Tiberion/important-documents/Bracket, sensor actuator- Addons/Circuit/Motorboard-Layout-1.tiff

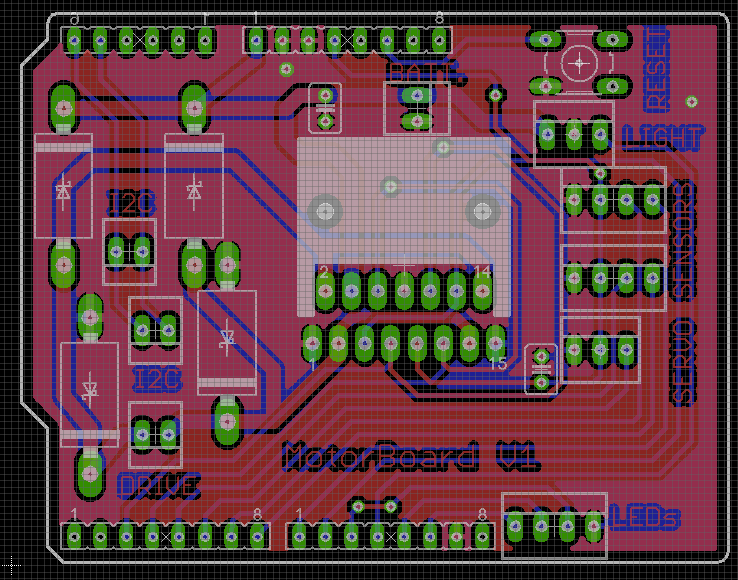
Bracket, sensor actuator- Addons/Circuit/Motorboard-Layout-1.tiff
