Tiberion/important-documents/README.md

important-documents
===================

This is a filesystem where you can find all finished documents.

[Here is the link to the mainpage of the wiki.](https://github.com/Carduinodroid/carduinodroid/wiki)
