Tiberion/important-documents/Start of the project/1 - Functional specification document/Presentation.pptx

Auto, Arduino, Android
- CarDuinoDroid

Lewandowski, Benjamin
Lewandowski, Felix
Behlau, Benjamin
Schulze, Christian
Strenger, Robin
Haueisen, Sven
Thorwirth, Paul
Vogel, Lars

CarDuinoDroid

## Slide 2

Gliederung

1. Einleitung
2. Anwendung
3. Zielkriterien
4. Umsetzung
5. Benutzeroberfläche
6. Unsere Zielbestimmungen

CarDuinoDroid

## Slide 3

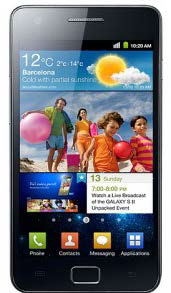
[picture p2: figure]

1. Einleitung

Teil 1: Arduino-Zugriff durch das AOADK

(Teil 2: Anbindung des Arduino-Boards an
die Modellfahrzeug-Bordelektronik)

Teil 3: Entwicklung einer Android-Applikation
als Drohnen-Steuer-Server

Teil 4: Entwicklung einer PC-Software
zur Drohnen-Steuerung

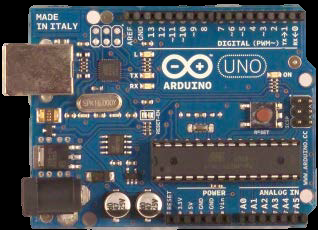
[picture p3: figure]
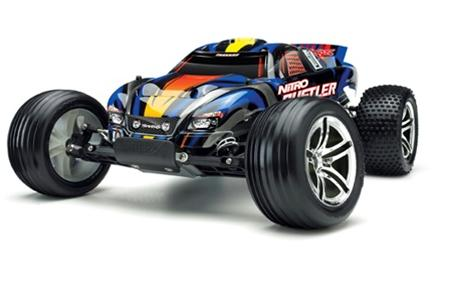
[picture p4: figure]

CarDuinoDroid

## Slide 4

2. Anwendung

Für wen?

Wo?

Wie?

Wie effizient ?

Anpassungsfähig?

CarDuinoDroid

## Slide 5

3. Zielkriterien

Muss
Wunsch
Abgrenzung

CarDuinoDroid

## Slide 6

4. Umsetzung

Android-Funktionen
Java-Funktionen
Oberfläche

CarDuinoDroid

## Slide 7

5. Benutzeroberfläche

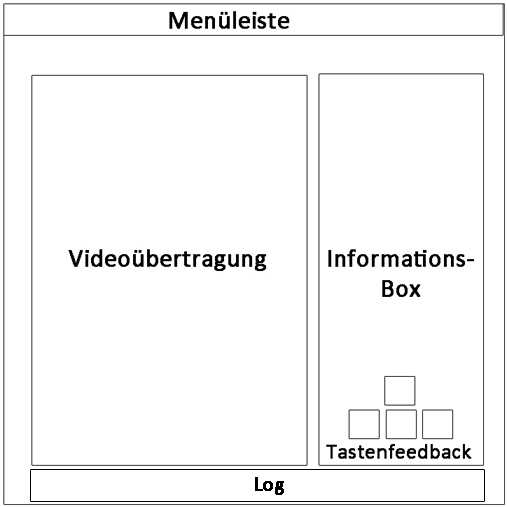
[picture p5: figure]

Möglicher
Oberflächenaufbau

CarDuinoDroid

## Slide 8

6. Unsere Zielbestimmungen

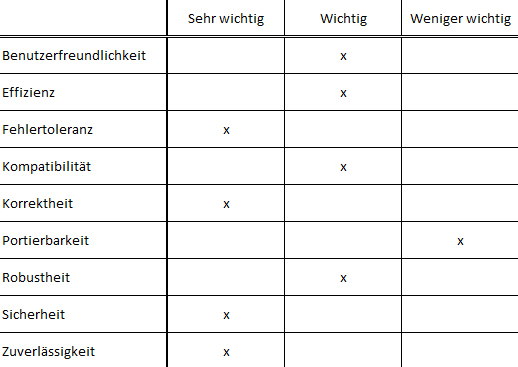
[picture p6: figure]

CarDuinoDroid

## Slide 9

Vielen Dank für Ihre Aufmerksamkeit!

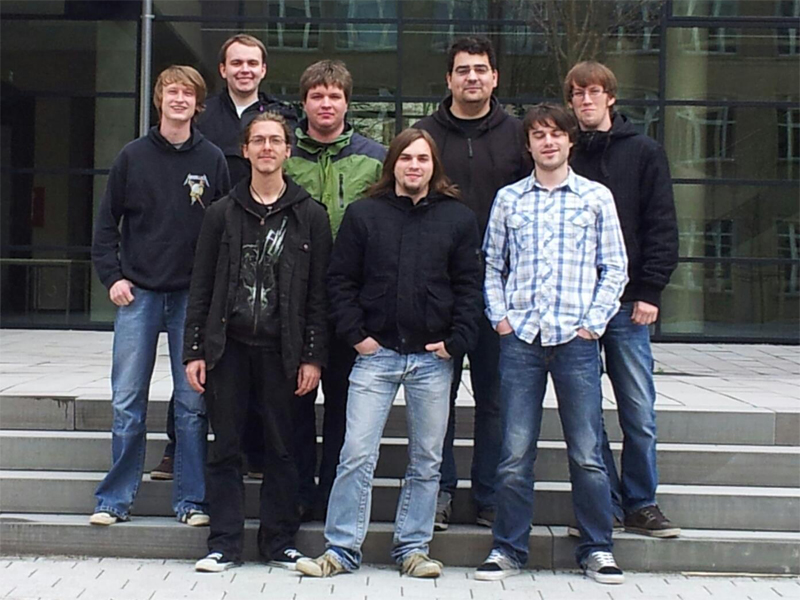
[picture p7: figure]

CarDuinoDroid
