Tiberion/important-documents/Bracket, sensor actuator- Addons/Presentation.pptx

## Sensor-Aktor-Integration auf einer mobilen Arduino-Plattform

Hauptseminar
Harald Funk

www.tu-ilmenau.de

## Gliederung

- Vorhandener Aufbau und Aufgabenstellung
- Erweiterung der Hard- und Software des Modellfahrzeuges
- Ansteuerung des entstandenen Gesamtsystems
- Zukünftige Erweiterungsmöglichkeiten
- Demonstration
- Quellen

## Vorhandener Aufbau

- Modellfahrzeug Street-Breaker der Firma Carson
- Umgebaut auf Ansteuerung durch einen Arduino
- Selbstgelötete Motortreiberplatine mit undokumentierter Schaltung
- Auf Arduino-Board gesteckt und mit Klebeband fixiert
- Smartphone als Bridge zwischen Steuerrechner und Arduino mit Klettband befestigt

Notes: Arduino nur mit 1 Schraube fixiert => Halterung gebaut

## Vorhandener Aufbau

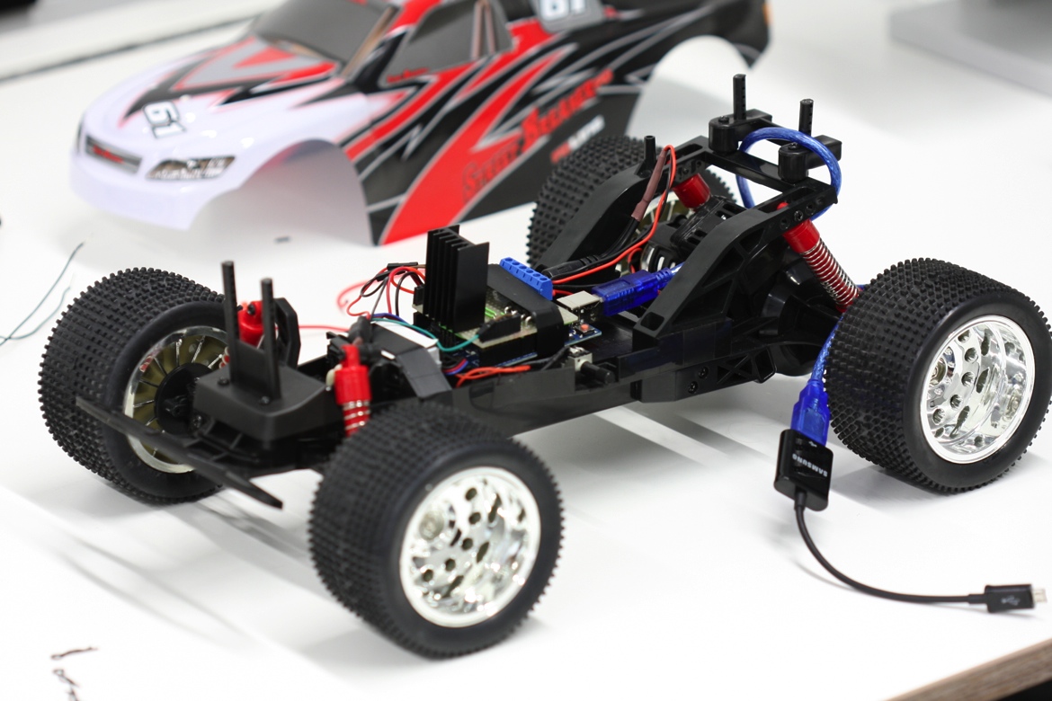
[picture p8: figure]
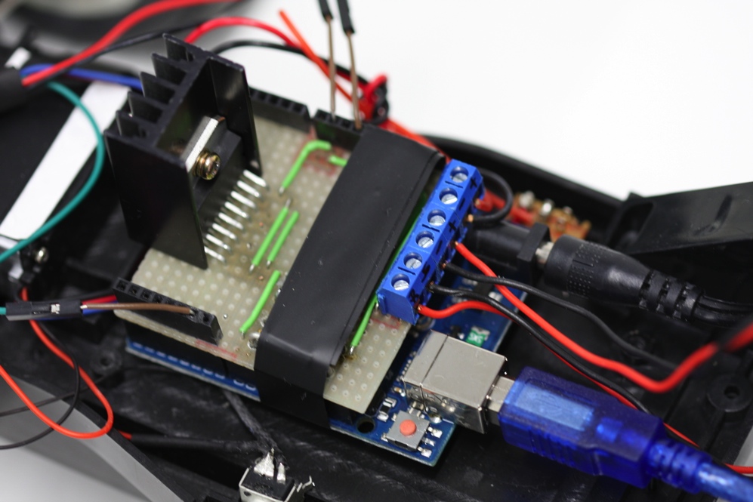
[picture p9: figure]

Notes: oben: Fahrzeug im Ganzen
langes USB-Kabel
unten: Treiberplatine
Schwerpunkt am vorderen Ende
Klebeband
Lochrasterplatine
Kabel ohne Befestigung gesteckt

## Aufgabenstellung

- Arduino- und Motorsteuerungsplatine sicher auf Fahrgestell befestigen
- 3 LEDs zur Anzeige von Power on/off, Connection on/off und frei programmierbar am Gehäuse anbringen und ansteuern
- 2 High-Power LEDs für Licht am Gehäuse anbringen und ansteuern
- Kapazitätsmessung der Batterie ermöglichen
- Handyhalterung entwickeln und einbauen
- Ultraschall-Sensor aussuchen, anbauen und implementieren
- Leitungen zwischen Platinen und Motoren neu und sauber verlegen
- USB-Kabel und Adapter kürzen

## Erweiterung der Hard- und Software

- Aufbau und Schaltung der Motorsteuerungsplatine
- Messung der Akkukapazität
- Verwendung und Auswertung des Ultraschallsensors HC-SR04
- Schaltung und Steuerung der High-Power LEDs und der Status-LEDs
- Konstruktion und Einbau der Handyhalterung

## Aufbau und Schaltung der Motorsteuerungsplatine

- Vorhandene Platine nicht erweiterbar
- Beibehaltung des grundlegenden Aufbaus
  - Entwicklung einer neuen Platine mit passenden Steckverbindern für Peripherie
- Beachtung des Schwerpunktes der Platine
- Schaltung und Layout mit Freeware Eagle

Notes: sehr eng und unsauber gelötet
Aufwand zum Ändern höher als Neuaufbau
Kondensatoren gemäß Datenblatt

## Aufbau und Schaltung der Motorsteuerungsplatine

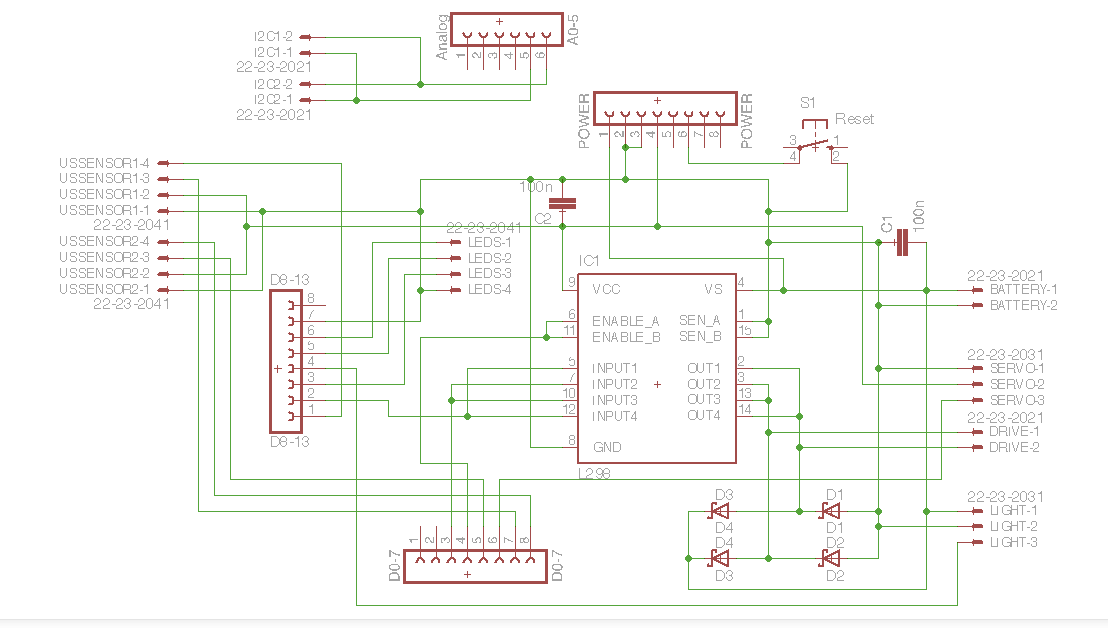
[picture p10: figure]

Notes: Mitte:L298N Motortreiber 2 Vollbrücken, antiparallel
Unten Rechts: Freilaufdioden für Überspannungsschutz
Oben Rechts: Reset-Knopf für Arduino
Ansonsten: Steckverbinder für Peripherie

## Aufbau und Schaltung der Motorsteuerungsplatine

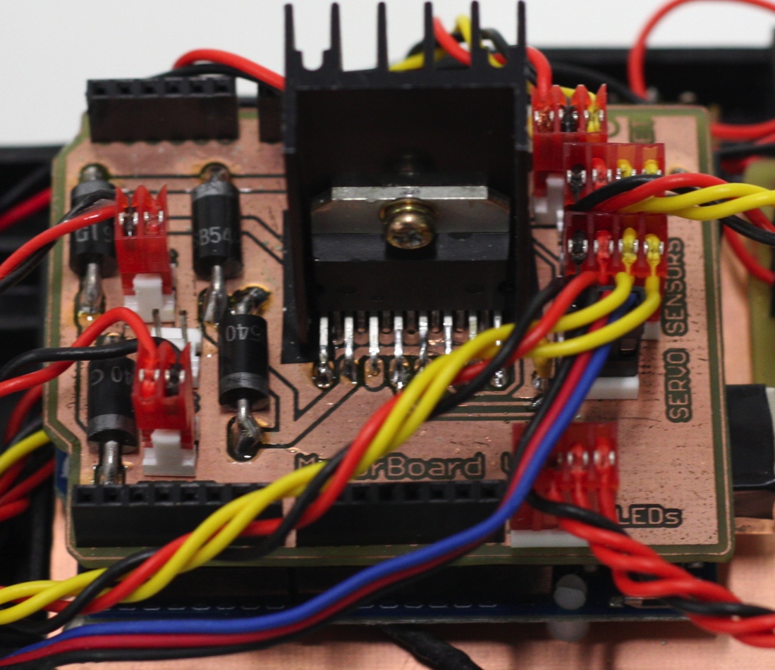
[picture p11: figure]
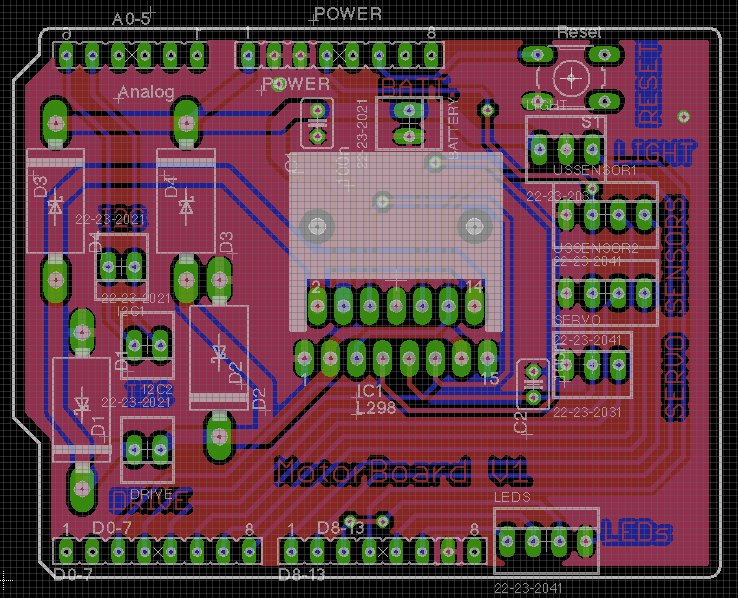
[picture p12: figure]

Notes: Platine wurde selbst entwickelt und geätzt

## Messung der Akkukapazität

- Auswahl einer geeigneten Methode Spannungsmessung Strommessung
- Spannungsmessung: Starke Nichtlinearität im Verhältnis Spannung/Kapazität → über weite Bereiche kaum messbar
- Strommessung: Integration des Stroms über die Zeit ≙ Kapazität
  - über spezialisierte ICs messbar

Notes: Nicht so einfach:
1,4V = voll
0.8V = leer
=> 1.1 V = halbvoll

## Messung der Akkukapazität

- Auswahl des DS2745 „Low-Cost Battery Management“ Chips
  - Messung des Spannungsabfalls (≙ Strom) über einen Präzisionswiderstand
  - Integration des gemessenen Spannungswertes
  - Ansprechbar mittels I²C-Bus über den Arduino
  - Erfasst ebenfalls Versorgungsspannung und Temperatur

Notes: +-51,2mV Spannungsmessbereich Auflösung 16Bit
Zweidrahtleitung
Speicherung in Registern, welche Ausgelesen und Beschrieben werden können

## Messung der Akkukapazität

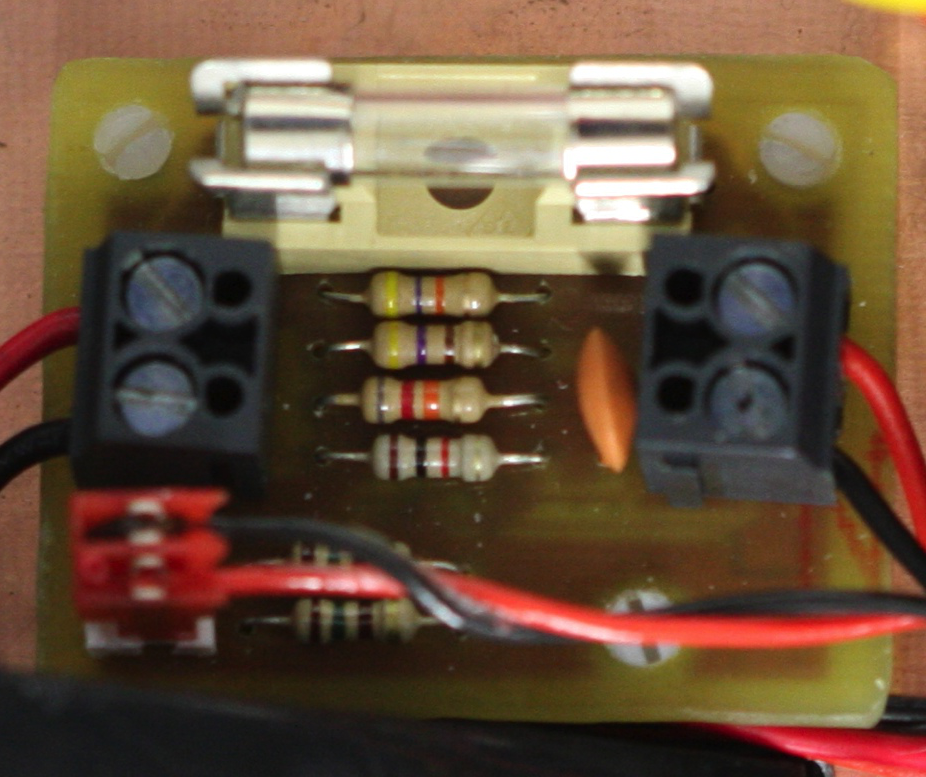
[picture p13: figure]
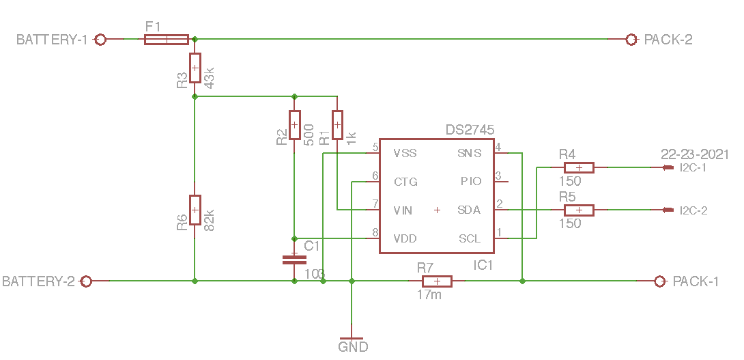
[picture p14: figure]
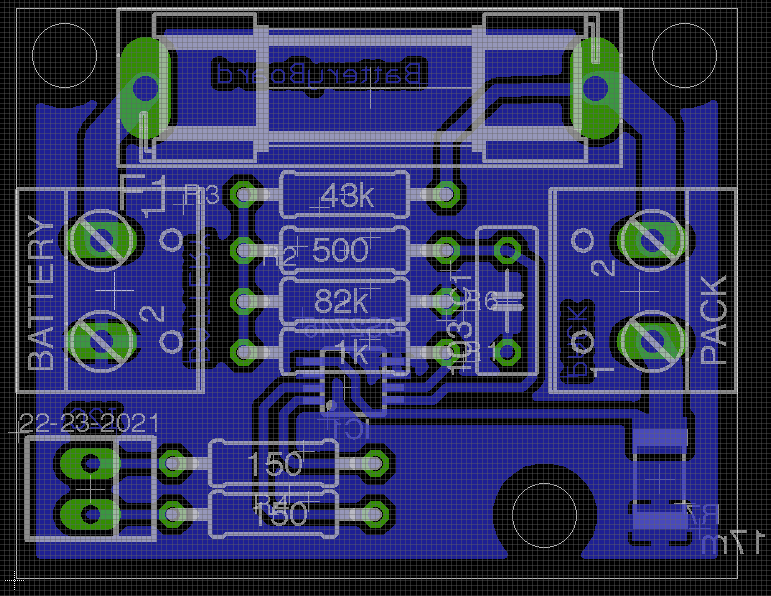
[picture p15: figure]

Notes: Mitte: DS2745 Battery Management
Links: Versorgungsspannung Batterie
Rechts: Spannungsausgang für Mikrokontroller
Unten: RSNS : ShuntWiderstand zur Messung des Stroms

## Verwendung und Auswertung des Ultraschallsensors HC-SR04

- Messung des Abstandes zu Hindernis in Fahrtrichtung (< 3m)
- Restriktiver Eingriff in Steuerbefehle abhängig vom Abstand
- Ansteuerung mittels Trigger- und Echo-Pins
- Messung der Zeit → Abstand zum Hindernis

Notes: 2 Sensoren montiert
Kein I2C oder UART, dafür billig

## Verwendung und Auswertung des Ultraschallsensors HC-SR04

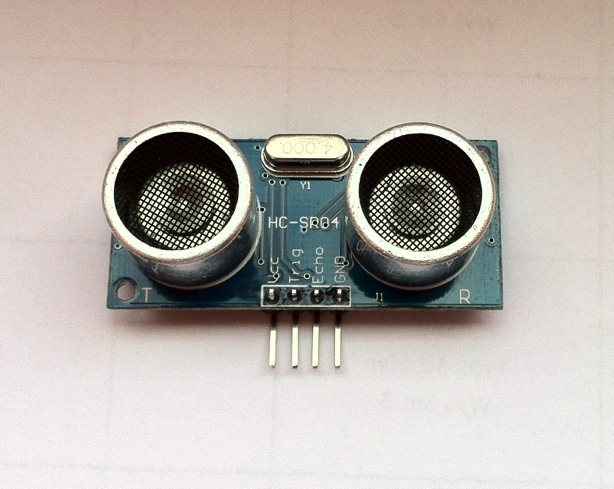
[picture p16: figure]
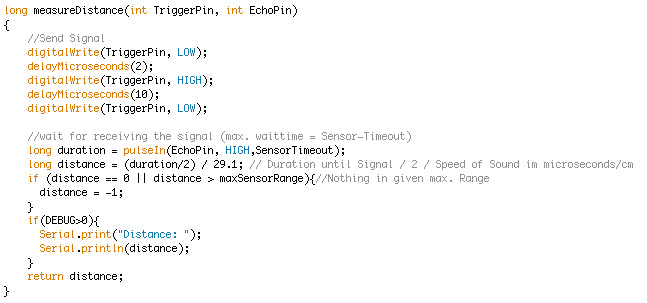
[picture p17: figure]

Notes: 2µs zur Stabilisierung des Pegels
Formel: Abstand = Zeitdauer/2/29.1cm/µs

## High-Power LEDs und Status-LEDs

- Einsatz von 2 x 1W-High-Power LEDs
- Ansteuerung mittels ILD4035 LED-Treiber (350mA)

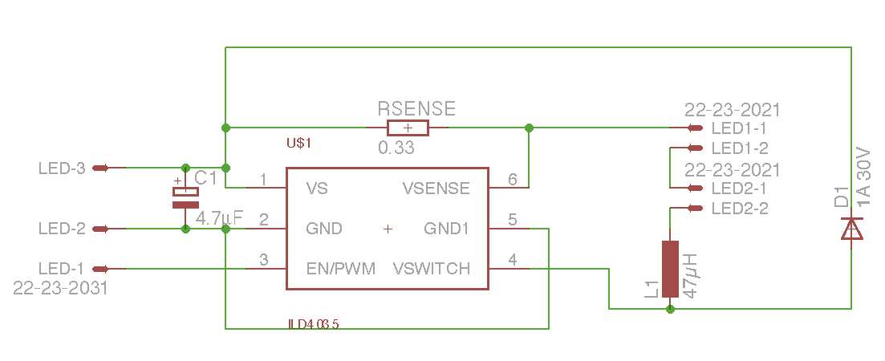
[picture p18: figure]

Notes: Mitte: ILD4035 Treiber
Kondensator: Abblocken hochfrequenter Störungen
Spule: Verringern des Ein-Ausschaltstroms
Diode: Schottky Ausführung => bricht schneller durch

## Konstruktion und Einbau der Handyhalterung

- Konstruktion mittels Autocad Inventor
- Druck auf 3D-Drucker des Fachgebiets IHS
- Anbau an Fahrgestell des Modellfahrzeuges
- Halterung für Micro-USB Kabel des Smartphones zum einfachem Verbinden durch Einstecken

## Konstruktion und Einbau der Handyhalterung

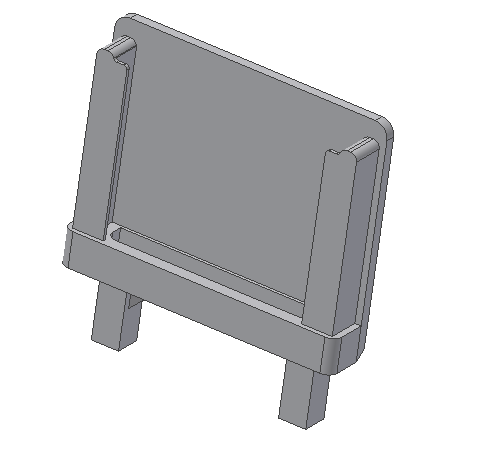
[picture p19: figure]
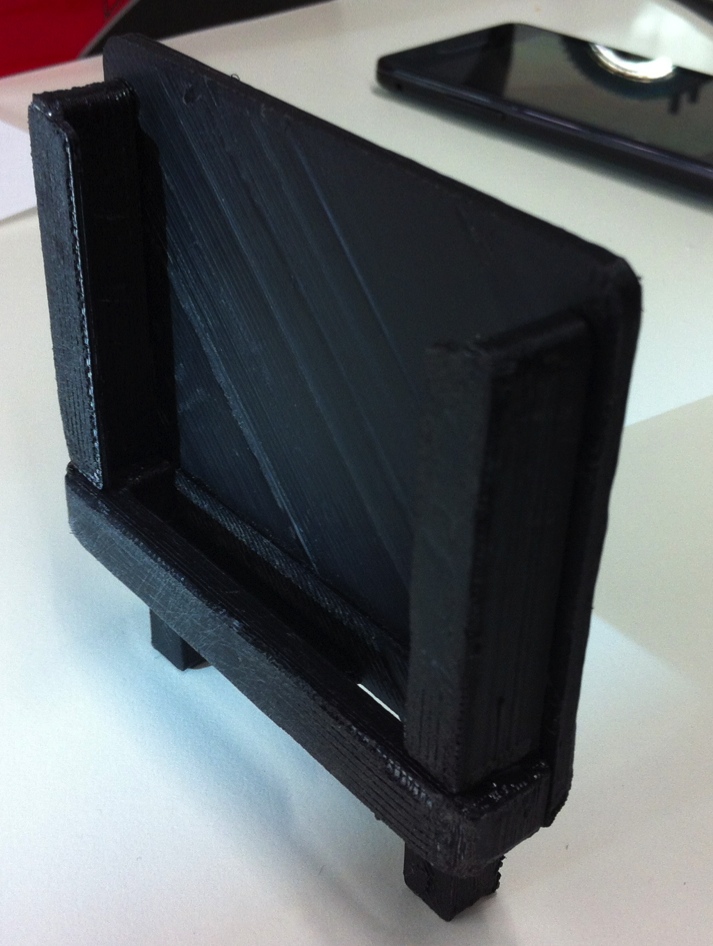
[picture p20: figure]

## Ansteuerung des entstandenen Gesamtsystems

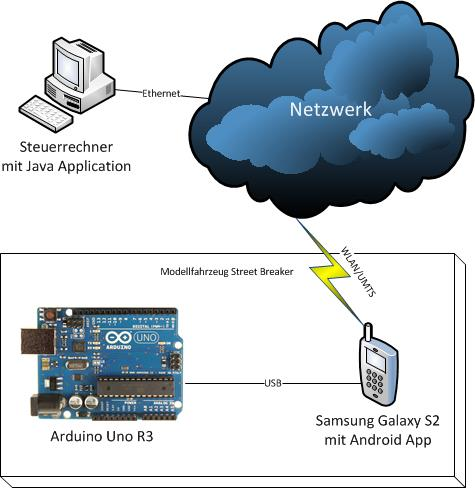
[picture p21: figure]

## Ansteuerung des entstandenen Gesamtsystems

- Java-Applikation und Android-App nicht Teil des Hauptseminars
- Durch Anbauten neues Protokoll zwischen Arduino und Smartphone notwendig
- Zusammenfassung mehrerer alter Steuerbytes
- Hinzufügen eines Protokoll-Headers, neues Byte für Anbauten
- Hinzufügen einer Status-Antwort auf Steuerbefehle

## Zukünftige Erweiterungsmöglichkeiten

- Erweiterung der vorhandenen Software auf neue Sensorik und Aktuatorik
- Anschluss weiterer I²C-kompatiblen Sensoren und Aktoren möglich
- Erweiterung des Protokolls über die Nutzung reservierter Bits oder einer neuen Protokollversion möglich

## Vielen Dank für Ihre Aufmerksamkeit

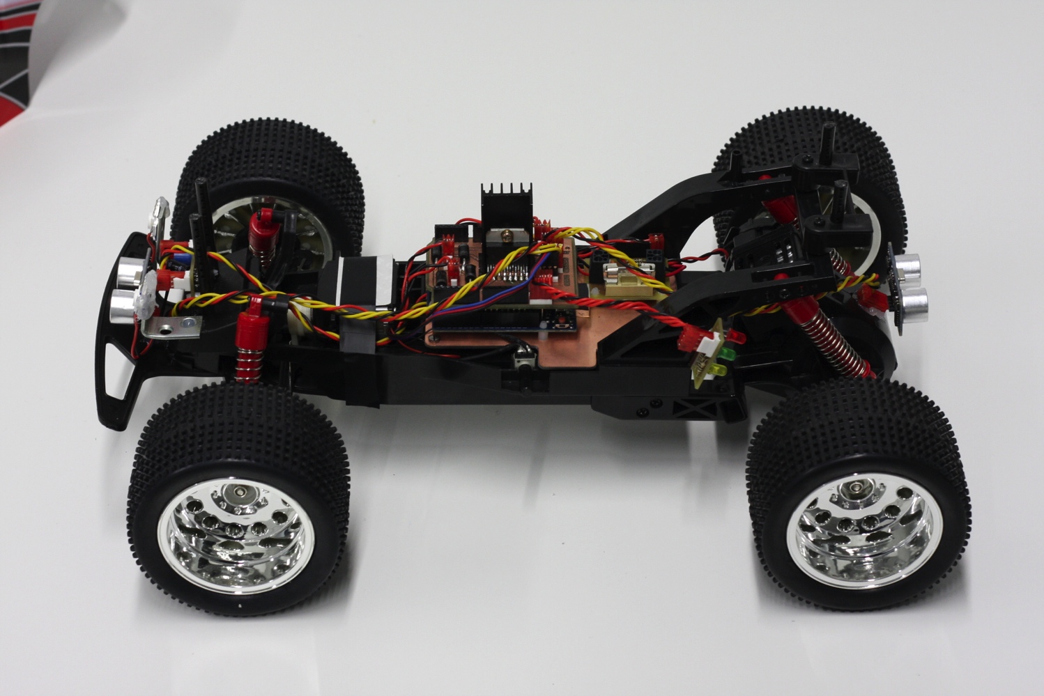
[picture p22: figure]

DEMO

## Quellen

- Schaltungstechnik; Johann Siegl; Springer Verlag; 3. Auflage
- Eagle Handbuch; Cadsoft Computer GmbH; Version 6 http://www.cadsoft.de/wp-content/uploads/2011/05/V6_manual_de.pdf
- Mikrocontroller.net; Leiterbahnbreite; Aufgerufen am 17.10.2013 http://www.mikrocontroller.net/articles/Leiterbahnbreite
- Akkukonfigurator.de; Firma Akkuline OHG; Aufgerufen am 30.09.2013; http://www.akkukonfigurator.de/NiCD-NiMH_Akku-Spannung.aspx
- Nickel-Metallhydrid-Akku; Elektronik-Kompendium; Aufgerufen am 30.09.2013; http://www.elektronik-kompendium.de/sites/bau/1101251.htm
- Datenblatt DS2745; Maxim Integrated; Version 2; Aufgerufen am 26.05.2013; http://datasheets.maximintegrated.com/en/ds/DS2745.pdf
- Arduino Homepage; arduino.cc; Aufgerufen am 19.07.2013;
- Arduino Playground; playground.arduino.cc; Aufgerufen am 19.07.2013
- Datenblattt HC - SR04; ElecFreaks.com; Aufgerufen am 04.10.2013; http://elecfreaks.com/store/download/HC-SR04.pdf
- Datenblatt ILD4035; Avago Technologies; Aufgerufen am 04.10.2013; http://www.avagotech.com/docs/AV02-1673EN
- Datenblatt L298N; STMicroelectronics ; Aufgerufen am 10.06.2013; http://www.st.com/st-web-ui/static/active/en/resource/technical/document/datasheet/CD00000240.pdf
