Tiberion/important-documents/Start of the project/3 - Implementation/Implementation process.pdf

1. | Teambesprechung 1. | Teambesprechung

## Zeitplanung Zeitplanung

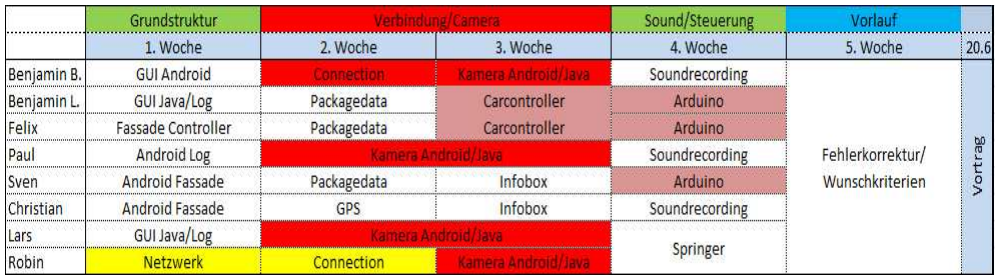
[picture p52: figure]

## Aufbau Grundstruktur Aufbau Grundstruktur

Aufbau der Fassaden Aufbau der Fassaden

GUI Java GUI Java

Grundversion der grafischen Oberfläche steht mit den grundlegenden Einstellmöglichkeiten.

Zudem wird an dieser weiterhin gearbeitet und alle neuen Funktionen implementiert.

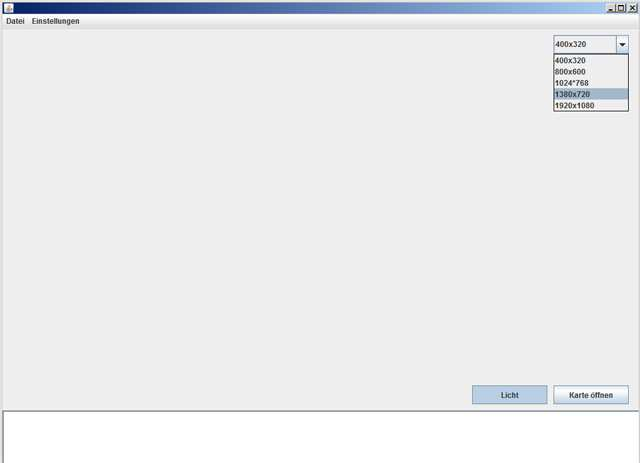
[picture p53: figure]

# GUI Android GUI Android

Anbei die fertiggestellte Oberfläche im Android.

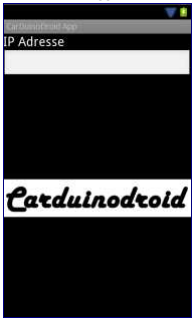
[picture p54: figure]

Log Java / Android Log Java / Android

Log Funktion vom Android komplett funktionsfähig. Währenddessen bei dem Java-Programm

noch Anpassungen erfolgen bezüglich kleiner Denkfehler im Entwurf.

## Aufgabenverteilung Aufgabenverteilung

Paul: GPS_Daten und Connection/Verbindung auslesen+ Zusammenführen Klassen

Robin: Verbindungsaufbau(Netzwerk) und Kameradaten(Aufnehmen und Senden)

Benjamin L: GUI_Java + Informationsbox mit Werten aktualisieren

Sven: Zusammenführen Klassen + JavaDoc/Doxygen belesen und Tutorial einbinden ins Trac

Benjamin B: Icon/IP-Auslesen, Eingliedern bei Problemen in Gruppen

Christian: Soundrecording

Felix: Soundpool, Controller_Java, Eingliedern bei Problemen in Gruppen

Lars: Package (Java auseinandernehmen)-Informationen + Android-Arduino

(Übertragung/Befehle)

Für alle Threads auslesen für Oberfläche Java und JavaDoc

# 2.Teambesprechung 2.Teambesprechung .Teambesprechung

# GUI Java GUI Java

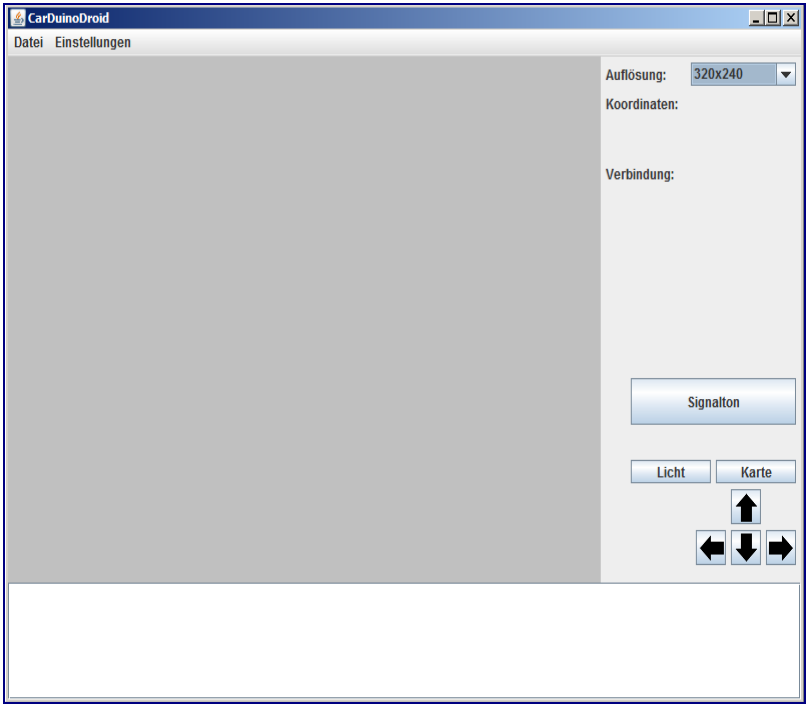
[picture p55: figure]

## GPS-/Verbindungsdaten auslesen /Verbindungsdaten auslesen /Verbindungsdaten auslesen

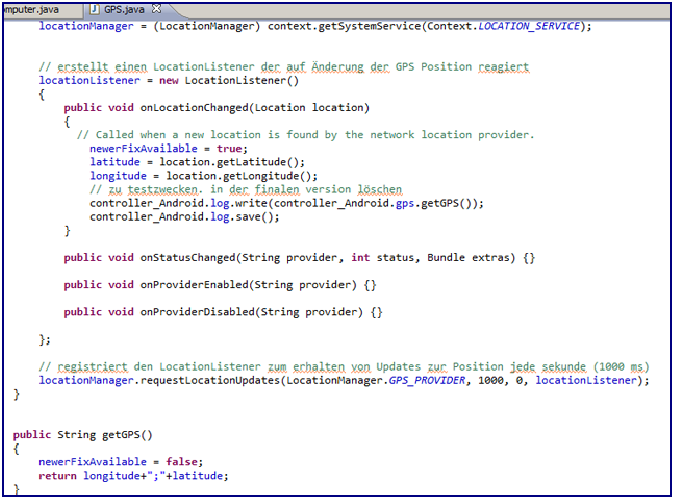
[picture p56: figure]

## Verbindungsaufbau Verbindungsaufbau

Das Senden von Informationen und Daten ist fertiggestellt. Die ersten Testwerte werden im

Zusammenspiel zwischen Lars und Robin erstellt und auseinandergenommen.

## Bildübertragung Bildübertragung

Das große Problem des Projektes, da die Übertragung bisher immer mit stärker Verzögerung

behaftet ist. Testprogramme klappen nur in geringen Prozentzahlen, wobei auch hier ein Delay

bis teilweise 10s vorhanden sind (je nach Umsetzungsart).

## IP-Adresse auslesen Adresse auslesen Adresse auslesen

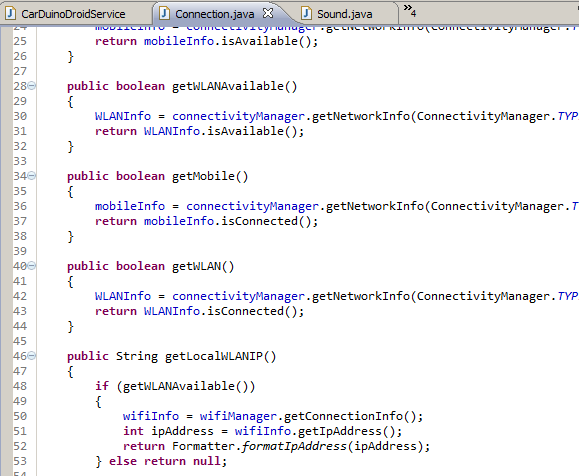
[picture p57: figure]

## Soundpool Soundpool

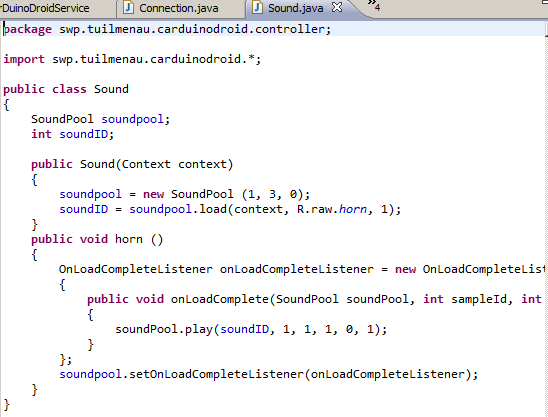
[picture p58: figure]

## Arduino- Arduino-Befehle senden Befehle senden Befehle senden

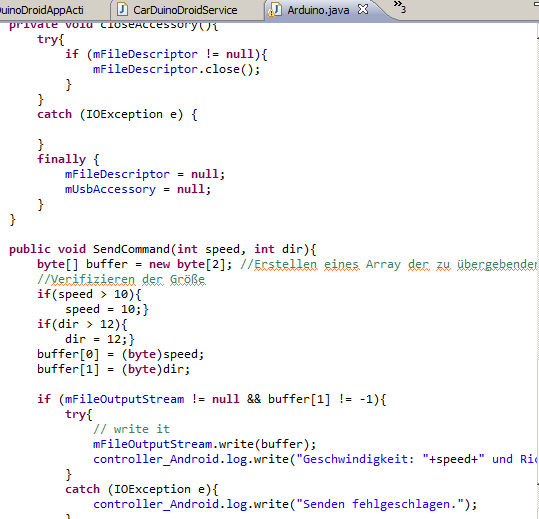
[picture p59: figure]

## Festlegung auf JavaDoc Festlegung auf JavaDoc

## Aufgabenverteilung Aufgabenverteilung

Benjamin L: GUI_Java mit Implementierung Methoden

Robin: Verbindungsaufbau(Netzwerk) und Kameradaten(Aufnehmen und Senden) sowie Android

App Rest

Lars: Sound Output + Camera Settings + Car Controller Java

Christian: Soundrecording + Paketdata Java

Sven: Entwurfsphase Trac fertigstellen + GPS Map plus Model GPS (gpx-Format)

Paul: Anpassen Arduino Service + Arduino Rest

Benjamin B: Springer

Felix: Springer

# 3. Teambesprechung

## Sound Output Sound Output

Klasse mit Methoden wurde mit dem ActionListener verknüpft und kann vollständig benutzt

werden. Log Funktion ist zudem implementiert, die sich in die Aktion "Sendeanforderung" und

die Prüfung einer erfolgreichen Aktion gliedert.

## Camera Setting Camera Setting

Alle notwendigen Methoden (Licht, Kameraauflösung und Kameratyp) wurden implementiert und

von der Oberfläche wird der Status ausgelesen. Die Log Funktion ist zudem implementiert, die

sich in die Aktion "Sendeanforderung" und die Prüfung einer erfolgreichen Aktion gliedert.

## Soundrecording Soundrecording

Das Starten und Stoppen wird als Signal aufbereitet sowie als Methoden zur Verfügung gestellt.

Die Log Funktion ist zudem implementiert, welche sich in die Aktion "Sendeanforderung" und

die Prüfung einer erfolgreichen Aktion gliedert.

## Packagedata Packagedata

Das Gliedern der empfangenen Message über das Netzwerk wird anhand der ";"-Trennung

gewährleistet und in einem Array gespeichert.

## Car Controller Car Controller

Der Konstruktor mit grundlegenden Methoden wurde bereitgestellt. Umrechnung für Lenkwinkel

und Geschwindigkeitsparameter wurde bisher noch nicht eingebunden. Zudem fehlt das

Auslesen/Übergeben der Werte von dem GUI.

## GPS Map/ Track GPS Map/ Track ap/ Track

Nicht Fertiggestellt

# Android Applikation Android Applikation

Große Schritte im Zusammenspiel der einzelnen Klassen sichergestellt. Umänderung von Service

auf Activity bedingt durch die Kamera. Hier muss eine Activity gewährleistet sein, um Bilddaten

auslesen sowie übertragen zu können. Arduino Klasse wurde dementsprechend verändert, dass

die Methodik auf Activity wieder umgestellt wurde und benötigt nun einen Echtzeittest, ob

übertragene Signale auf Seiten des Arduino verarbeitet werden können.

## Aufgabenverteilung : Aufgabenverteilung :

Java

Benjamin L.: GUI (Car_Controller Elemente auf GUI, Bildverarbeiten/-anzeigen,

Feinheiten)

Lars: ActionListener (restliche Verknüpfung mit GUI)

Springer: Camera Pic weiterleiten

Christian: Package Data

Sven, Felix, Benjamin B.: GPS: Button zum Anzeigen Google Maps und *.gpx speichern

Robin: Kamerabilder übertragen

## Android

Robin, Paul:

Kamera

Controller

Arduino anpassen (Rest)

# 4.Teambesprechung 4.Teambesprechung

## Car_Controller mit KeyListener Car_Controller mit KeyListener

Funktionierende Abfrage der Tasten über Variablen setzen/löschen gelöst, um den

Mehrfachdruck zu lösen. Dabei kann einerseits das Auto per Pfeiltasten gelenkt und zu gleicher

Zeit die beigefügten Gänge zur Regulierung der Geschwindigkeit genutzt werden. Auch besteht

die Möglichkeit den Lenkwinkel zu steuern, um zu starke kurven bei hoher Geschwindigkeit zu

vermeiden. Dieser Funktionsumfang kommt vollkommen ohne Logeinträge aus, um unnötigen

Datentraffic zu vermeiden.

## *.gpx-File (Wunschkriterium) File (Wunschkriterium) File (Wunschkriterium)

Das Speichern des Routenverlaufes einer Strecke wird dahingehend gewährleistet, dass eine

demnentsprechende Datei beim Start des Java-Programms angelegt wird, die bei neuen GPS-

Informationen die wichtigen Daten in den Log schreibt. Mit dem normalen Beenden des

Programms wird die Datei mit den restlichen Informationen gefüllt, um auf diversen

Routenprogrammen sowie Internetseiten die Strecke anzeigen zu können.

## Verbinden ActionListener mit GUI Verbinden ActionListener mit GUI

Restliche ActionListener wurden mit den Aufrufen auf der GUI verbunden. Mit dem Log konnte

die Funktionalität sicher gestellt werden.

# Live-Log

Die detaillierte und zeitnahe Anzeige des Live-Logs auf dem GUI versorgt den Nutzer mit

ausreichend Informationen über den genutzten Funktionsumfanges des Programms. Fehler in

Verbindung sowie Sendeprobleme werden darin auch ausgewiesen.

## JavaDoc Beispiel JavaDoc Beispiel

Ein erstes JavaDoc Beispiel wurde in eine der zahlreichen Klassen eingebunden, um für alle

anderen die nötigen Grundlagen zu schaffen, die eigenen Programmteile zu dokumentieren.

Besonders die Beschreibung von Methoden und der Klasse stellen den Hauptbestandteil dar.

## Sprachdateien einbindbar Sprachdateien einbindbar

Man kann per Sprachdateien die komplette Oberfläche einfach und unkompliziert ändern. Dabei

müssen die Einträge nur zeilenweise übersetzt und angepasst werden. Dies gewährleistet eine

internationale Nutzung des Programms

## unvollständige Teile unvollständige Teile

Arduino-USB-Steuerung: durch fehlene Testmöglichkeit kann die Klasse mit den

jeweiligen Methoden nicht in einer Live-Umgebung getestet werden

Bildübertragung: Probleme bezüglich der Verzögerung in vielen getesteten

Programmiervarianten haben bisher die Anzeige erschwert. Weitere Methoden werden

ausprobiert um das "Delay" auf ein Minimum zu reduzieren. Weiterhin noch Hardware

technische Probleme bezüglich der Bilderverarbeitung (teilweise Handys zu langsam)

Aufgabenverteilung letzte Implementierungswoche Aufgabenverteilung letzte Implementierungswoche

JavaDoc auskommentieren für alle. Robin/Paul:

Rest von Android Felix/Sven/Paul: Darstellung der Bilddaten auf GUI Java

Benjamin/Lars: Anpassungssachen Java

Christian: Vortrag Teile entwerfen, PDF
