Tiberion/important-documents/Bracket, sensor actuator- Addons/Circuit/attachment-schematics.tiff

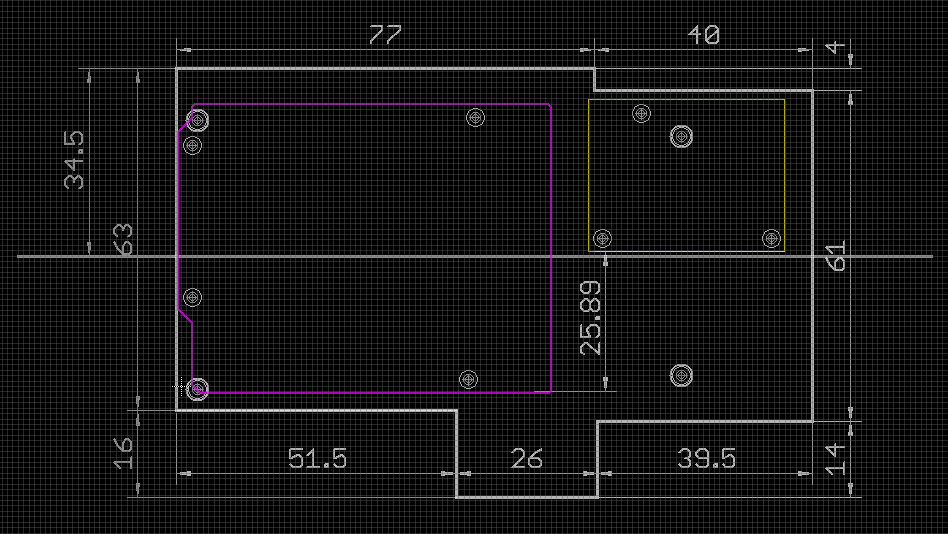
Bracket, sensor actuator- Addons/Circuit/attachment-schematics.tiff
