Tiberion/important-documents/Bracket, sensor actuator- Addons/Circuit/Battery-Layout-1.tiff

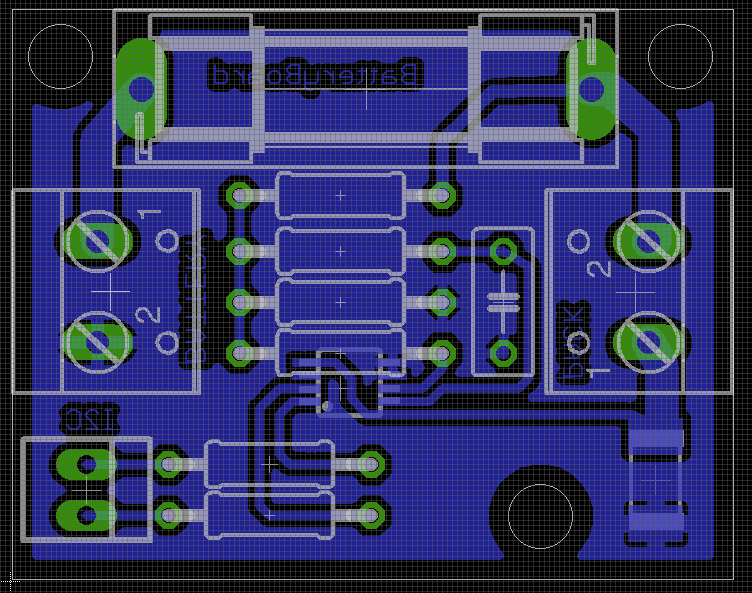
Bracket, sensor actuator- Addons/Circuit/Battery-Layout-1.tiff
