Tiberion/important-documents/Bracket, sensor actuator- Addons/Circuit/LED-Schematics.tiff

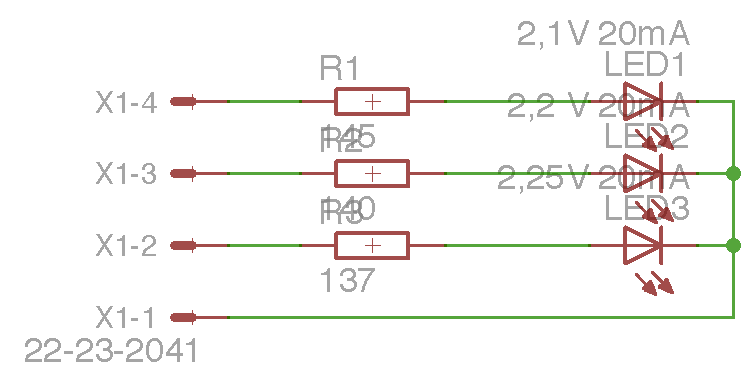
Bracket, sensor actuator- Addons/Circuit/LED-Schematics.tiff
