Tiberion/important-documents/Bracket, sensor actuator- Addons/Circuit/LEDs-Layout-1.tiff

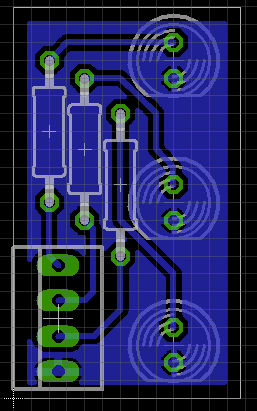
Bracket, sensor actuator- Addons/Circuit/LEDs-Layout-1.tiff
