Tiberion/important-documents/Bracket, sensor actuator- Addons/Circuit/LEDs-Layout.tiff

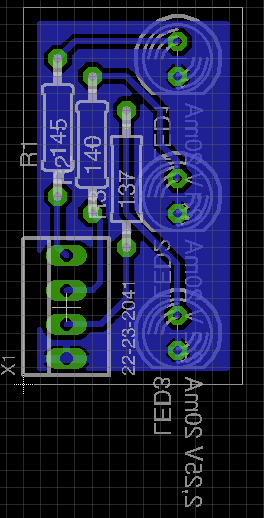
Bracket, sensor actuator- Addons/Circuit/LEDs-Layout.tiff
