Tiberion/important-documents/Bracket, sensor actuator- Addons/Circuit/Lightboard-Layout-1.tiff

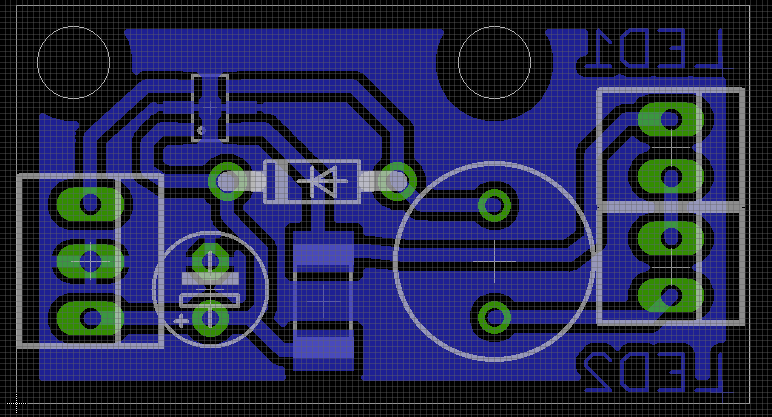
Bracket, sensor actuator- Addons/Circuit/Lightboard-Layout-1.tiff
