Tiberion/important-documents/Bracket, sensor actuator- Addons/Circuit/Lightboard-Layout.tiff

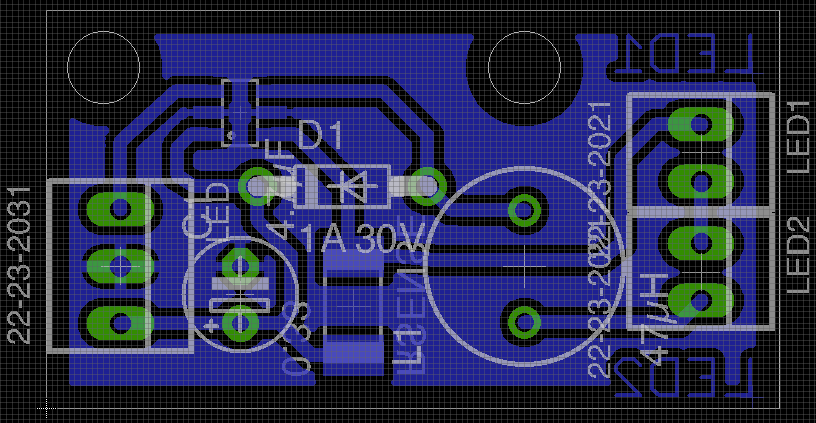
Bracket, sensor actuator- Addons/Circuit/Lightboard-Layout.tiff
