Tiberion/important-documents/Carduinodroi.de/2 - Draft/Classdiagramm.png

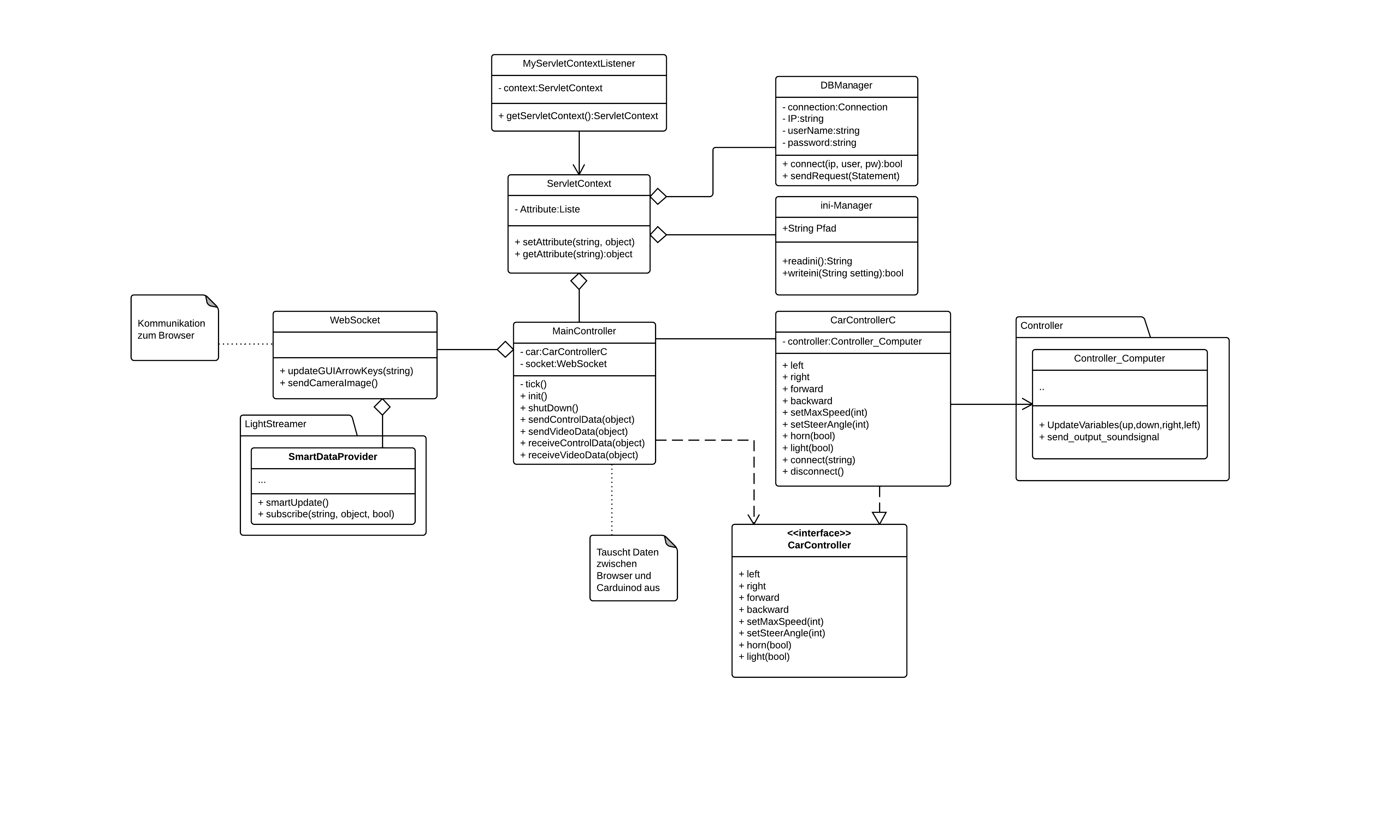
Carduinodroi.de/2 - Draft/Classdiagramm.png
