Tiberion/important-documents/Bracket, sensor actuator- Addons/3D-Model/baseplate_disassembled_ASCII.stl

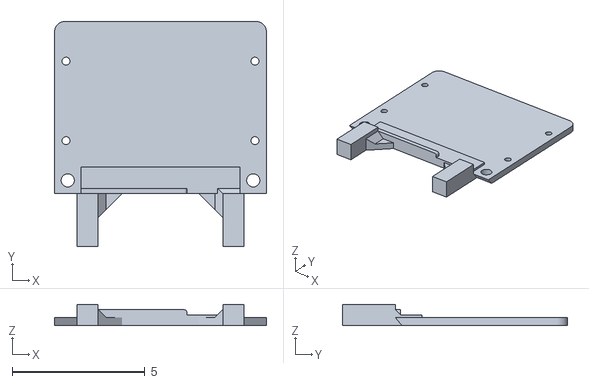
[picture p114: CAD file, 2014-06-21]
Bracket, sensor actuator- Addons/3D-Model/baseplate_disassembled_ASCII.stl
8.00 x 8.50 x 0.8
