Tiberion/important-documents/Bracket, sensor actuator- Addons/3D-Model/USB-bracket.stl

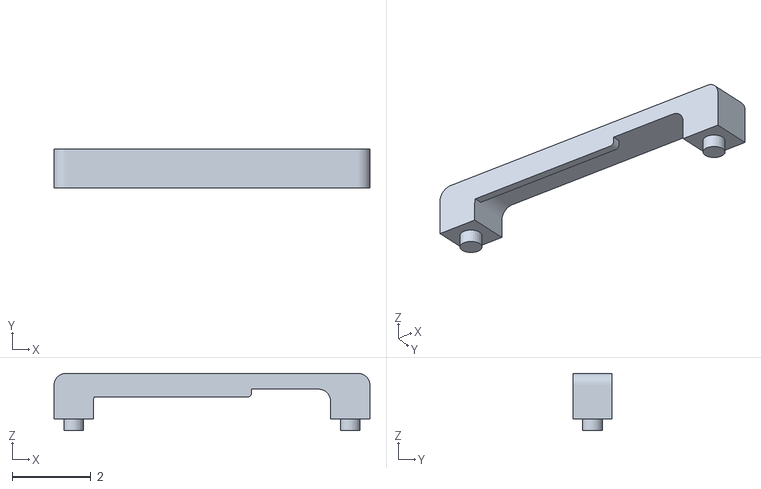
[picture p115: CAD file, 2014-06-21]
Bracket, sensor actuator- Addons/3D-Model/USB-bracket.stl
8.00 x 1.00 x 1.45
