Tiberion/important-documents/Bracket, sensor actuator- Addons/3D-Model/bracket_right_ASCII.stl

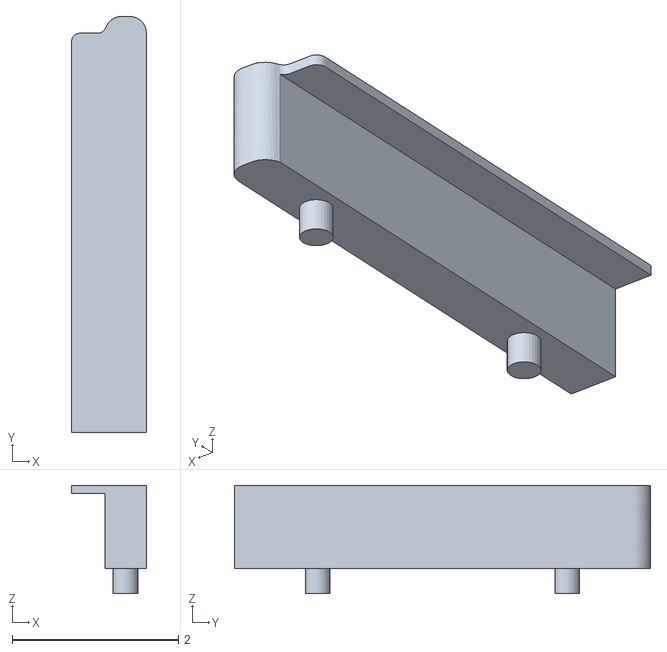
[picture p116: CAD file, 2014-06-21]
Bracket, sensor actuator- Addons/3D-Model/bracket_right_ASCII.stl
0.9 x 5.00 x 1.30
