Tiberion/important-documents/(list of files, cad)

Other CAD files:
Bracket, sensor actuator- Addons/3D-Model/baseplate_disassembled.stl
Bracket, sensor actuator- Addons/3D-Model/bracket_left_ASCII.stl
Bracket, sensor actuator- Addons/3D-Model/USB-bracket_ASCII.stl
Bracket, sensor actuator- Addons/3D-Model/bracket_left.stl
Bracket, sensor actuator- Addons/3D-Model/bracket_right.stl
Bracket, sensor actuator- Addons/3D-Model/Inventor files/Befestigung.ipt
Bracket, sensor actuator- Addons/3D-Model/Inventor files/Galaxy S2.ipt
Bracket, sensor actuator- Addons/3D-Model/Inventor files/Grundplatte.ipt
Bracket, sensor actuator- Addons/3D-Model/Inventor files/Grundplatte_zerlegt.ipt
Bracket, sensor actuator- Addons/3D-Model/Inventor files/Halter.ipt
Bracket, sensor actuator- Addons/3D-Model/Inventor files/Halter_Verschraubung.ipt
Bracket, sensor actuator- Addons/3D-Model/Inventor files/Halter_links.ipt
Bracket, sensor actuator- Addons/3D-Model/Inventor files/Halter_rechts.ipt
Bracket, sensor actuator- Addons/3D-Model/Inventor files/Handyhalterung.iam
Bracket, sensor actuator- Addons/3D-Model/Inventor files/Handyhalterung.idw
Bracket, sensor actuator- Addons/3D-Model/Inventor files/Handyhalterung_neu.iam
Bracket, sensor actuator- Addons/3D-Model/Inventor files/USB-Halter.ipt
