Tiberion/important-documents/Bracket, sensor actuator- Addons/typical debugging values.docx

# Typische Debug-Werte zur Eingabe über Windows:

Protocol Header:

Protokol Version | Reserved | Length
01 | 00 | 0011

(01000011)2 = (67)10 = Alt + 0067 = C (Mac: C)

Speed:

Speed-Vale | Speed Direction | Reserved
1001 | 1 | 000
0011 | 0 | 000
1100 | 0 | 000

(10011000)2 = (152)10=Alt+0152 = ~ (Mac: ò)

(00110000)2 = (48)10=Alt+0048 = 0 (Mac: 0)

(11000000)2 = (192)10=Alt+0192 = À (Mac: ¿) (exceed speed limit and stop the car)

Steering:

Speed-Vale | Speed Direction | Reserved
1000 | 1 | 000
0011 | 0 | 000

(10001000)2 = (136)10=Alt+0136 = ^ (Mac: à)

(00110000)2 = (48)10=Alt+0048 = 0 (Mac: 0)

Lights & Battery:

LED Status | Light Status | Reserved | Reserved | Reset Acc Current | Reserved
0 | 0 | 1* | 0 | 0 | 000
1 | 0 | 0 | 0 | 0 | 000
0 | 1 | 0 | 0 | 0 | 000
1 | 1 | 0 | 0 | 0 | 000
0 | 0 | 1* | 0 | 1 | 000

(00100000)2 = (32)10=Alt+0032 = (Mac: ) „Leerstelle“

(10000000)2 = (128)10=Alt+0128 = € (Mac: Ä)

(01000000)2 = (64)10=Alt+0064 = @ (Mac: @)

(11000000)2 = (192)10=Alt+0192 = À (Mac: ¿)

(00101000) 2 = (40)10=Alt+0008 = ( (Mac: ()

* to get valid Alt+ values
