Tiberion/important-documents/Bracket, sensor actuator- Addons/3D-Model/bracket_TZ.pdf

80,00

66,30

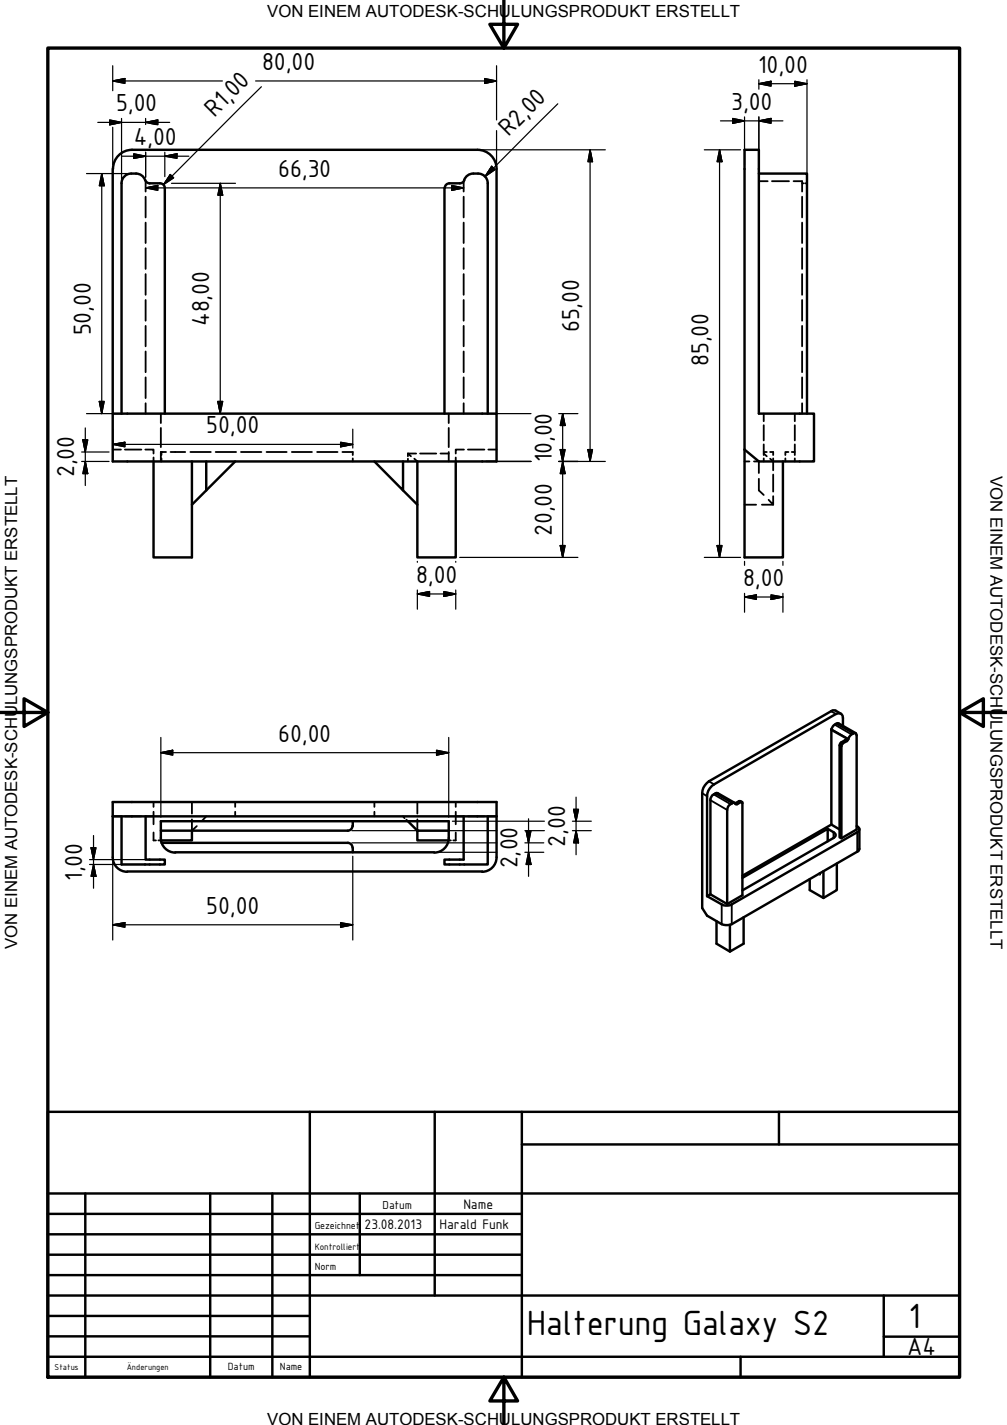
[picture p130: page 1]
EIN; ULU; ELLT; C H ULU; N G S P R O D U K T E R S T ELLT; Halterung Galaxy S2; Status; |nderungen; Datum; Name; Gezeichnet; Kontrolliert; Norm; Harald Funk

VON EINEM AUTODESK-SCHULUNGSPRODUKT ERSTELLT
