Tiberion/important-documents/Bracket, sensor actuator- Addons/3D-Model/Inventor files/Handyhalterung_neu.pdf

80,00

66,30

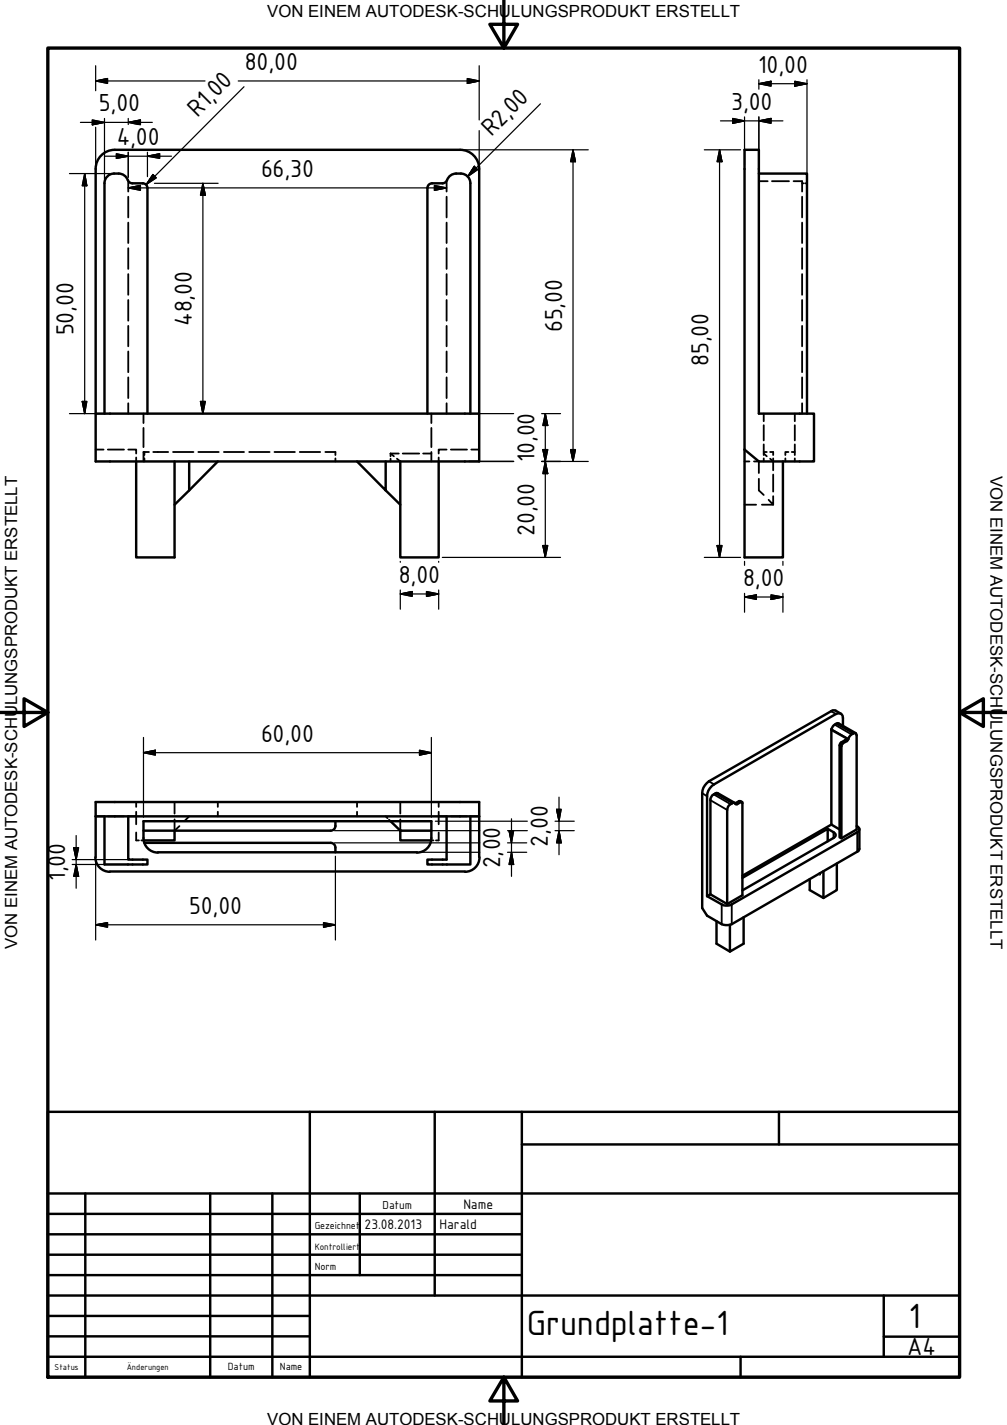
[picture p131: page 1]
EIN; ULU; ELLT; C H ULU; N G S P R O D U K T E R S T ELLT; Grundplatte-1; Status; |nderungen; Datum; Name; Gezeichnet; Kontrolliert; Norm; Harald

VON EINEM AUTODESK-SCHULUNGSPRODUKT ERSTELLT
