Tiberion/important-documents/Bracket, sensor actuator- Addons/Circuit/Eagle/Light board/Light board.brd

## EAGLE design Bracket, sensor actuator- Addons/Circuit/Eagle/Light board/Light board.brd (2014-06-21)

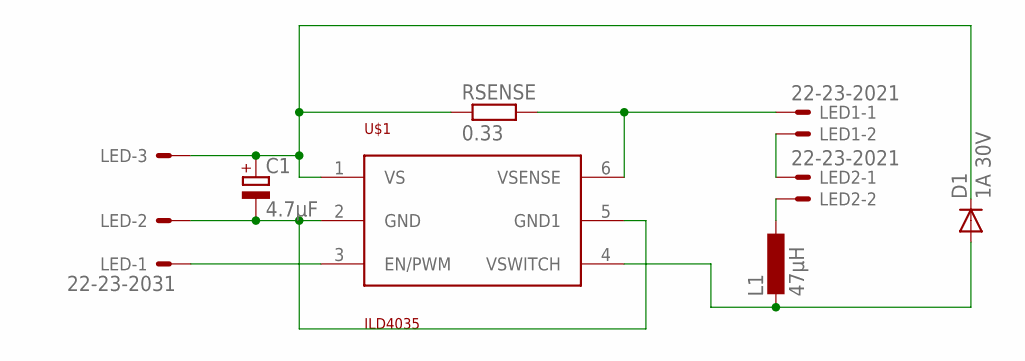
[picture p132: schematic Light board.sch]

Parts:
C1: 4.7µF; E2,5-5
D1: 1A 30V; DO41-7.6
L1: 47µH; 6000-XXXX-RC
LED: 22-23-2031
LED1, LED2: 22-23-2021
RSENSE: 0.33; R2010
U$1: ILD4035; SC74

Connections:
GND: C1.-, LED.2, U$1.2 (GND), U$1.5 (GND1)
unnamed: LED.1, U$1.3 (EN/PWM)
unnamed: C1.+, D1.C, LED.3, RSENSE.1, U$1.1 (VS)
unnamed: LED1.2, LED2.1
unnamed: L1.1, LED2.2
unnamed: LED1.1, RSENSE.2, U$1.6 (VSENSE)
unnamed: D1.A, L1.2, U$1.4 (VSWITCH)

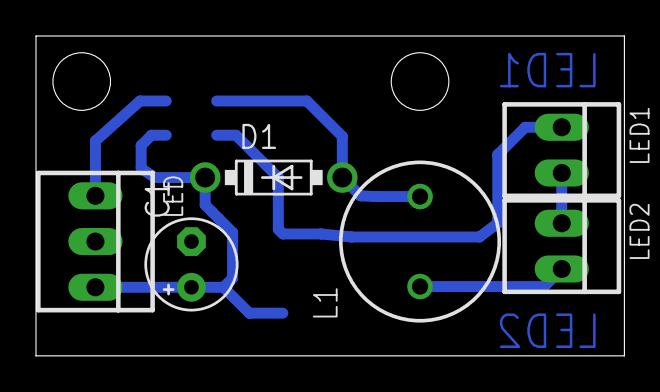
[picture p133: board Light board.brd from above]

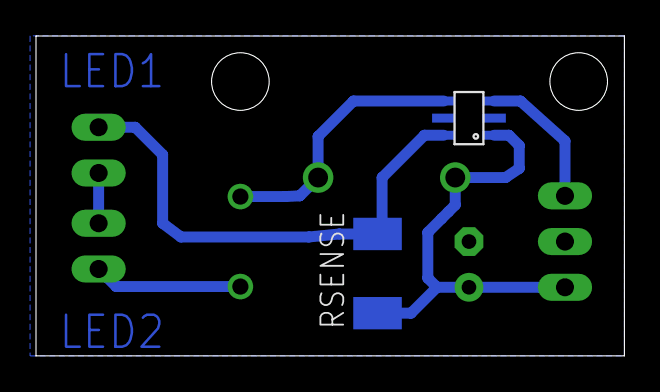
[picture p134: board Light board.brd from below]

Board: 2 copper layers, 32.7 x 17.8 mm, 8 parts (2 on the bottom side), 7 nets.
