Tiberion/important-documents/Bracket, sensor actuator- Addons/Circuit/Eagle/motor steering/motor steering.brd

## EAGLE design Bracket, sensor actuator- Addons/Circuit/Eagle/motor steering/motor steering.brd (2014-06-21)

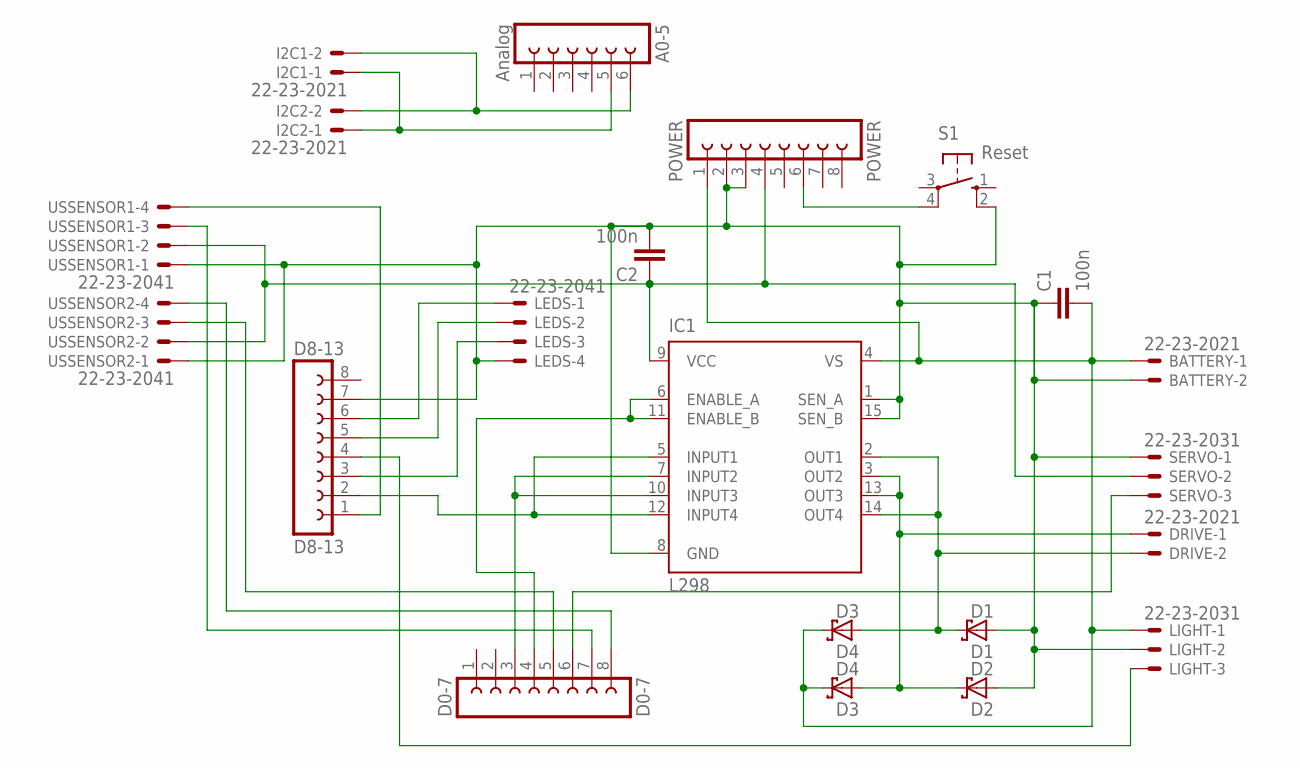
[picture p135: schematic motor steering.sch]

Parts:
A0-5: Analog; FE06
BATTERY: 22-23-2021
C1, C2: 100n; C025-030X050
D0-7: D0-7; FE08
D1: D1; DO201T15
D2: D2; DO201T15
D3: D4; DO201T15
D4: D3; DO201T15
D8-13: D8-13; FE08
DRIVE: 22-23-2021
I2C1: 22-23-2021
I2C2: 22-23-2021; MPN 22-23-2021
IC1: L298; MULTIWATT-15
LEDS: 22-23-2041
LIGHT: 22-23-2031
POWER: POWER; FE08
S1: Reset; B3F-10XX
SERVO: 22-23-2031
USSENSOR1, USSENSOR2: 22-23-2041; MPN 22-23-2041

Connections:
GND: BATTERY.2, C1.1, C2.2, D1.A, D2.A, D8-13.7, IC1.1 (SEN_A), IC1.8 (GND), IC1.15 (SEN_B), LEDS.4, LIGHT.2, POWER.2, POWER.3, S1.2 (S1), SERVO.1, USSENSOR1.1, USSENSOR2.1
unnamed: D1.C, D4.A, DRIVE.2, IC1.2 (OUT1), IC1.14 (OUT4)
unnamed: D0-7.6, SERVO.3
unnamed: D0-7.8, USSENSOR2.4
unnamed: D2.C, D3.A, DRIVE.1, IC1.3 (OUT2), IC1.13 (OUT3)
unnamed: D8-13.5, LEDS.2
unnamed: D8-13.2, IC1.5 (INPUT1), IC1.12 (INPUT4)
unnamed: D0-7.5, USSENSOR2.3
unnamed: D0-7.3, IC1.7 (INPUT2), IC1.10 (INPUT3)
unnamed: D0-7.4, IC1.6 (ENABLE_A), IC1.11 (ENABLE_B)
unnamed: D8-13.1, USSENSOR1.4
unnamed: D8-13.3, LEDS.3
unnamed: D8-13.4, LIGHT.3
unnamed: D8-13.6, LEDS.1
unnamed: D0-7.7, USSENSOR1.3
unnamed: A0-5.5, I2C1.1, I2C2.1
unnamed: POWER.6, S1.4 (P1)
unnamed: A0-5.6, I2C1.2, I2C2.2
VCC: C2.1, IC1.9 (VCC), POWER.4, SERVO.2, USSENSOR1.2, USSENSOR2.2
VS: BATTERY.1, C1.2, D3.C, D4.C, IC1.4 (VS), LIGHT.1, POWER.1

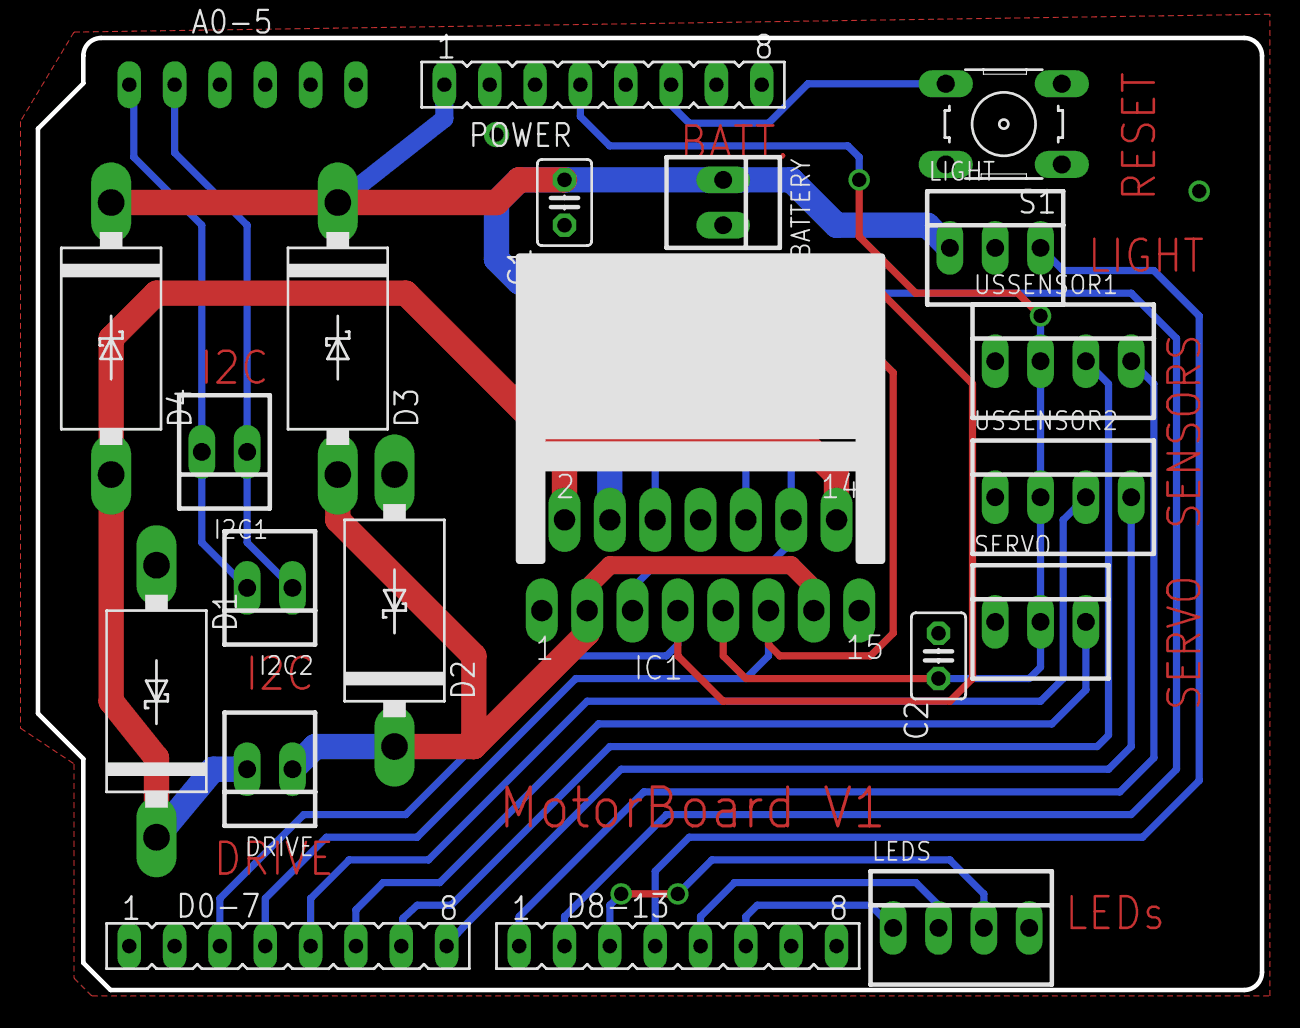
[picture p136: board motor steering.brd from above]

Board: 2 copper layers, 68.6 x 53.3 mm, 21 parts (1 on the bottom side), 20 nets.
