Tiberion/important-documents/Bracket, sensor actuator- Addons/Circuit/Eagle/Motorsteuerung/Motorsteuerung alte Version.brd

## EAGLE design Bracket, sensor actuator- Addons/Circuit/Eagle/motor steering/motor steering old version.brd (2014-06-21, an earlier design)

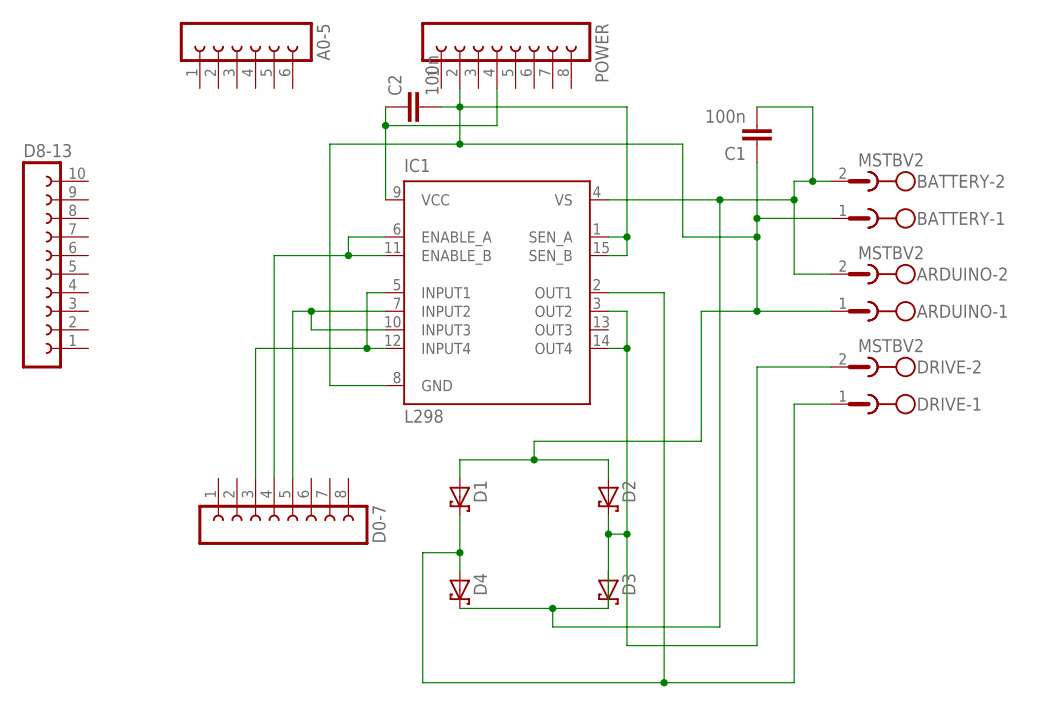
[picture p137: schematic motor steering old version.sch]

Parts:
A0-5: FE06-1; FE06
ARDUINO: MSTBV2
BATTERY: MSTBV2
C1, C2: 100n; C025-030X050
D0-7: FE08-1; FE08
D1, D2, D3, D4: SCHOTTKY-DIODEDO201T15; DO201T15
D8-13: FE10-1; FE10
DRIVE: MSTBV2
IC1: L298; MULTIWATT-15
POWER: FE08-1; FE08

Connections:
unnamed: D1.C, D4.A, DRIVE.1, IC1.2 (OUT1)
unnamed: ARDUINO.2, BATTERY.2, C1.2, D3.C, D4.C, IC1.4 (VS)
unnamed: D2.C, D3.A, DRIVE.2, IC1.3 (OUT2), IC1.14 (OUT4)
unnamed: C2.1, IC1.9 (VCC), POWER.4
unnamed: D0-7.3, IC1.5 (INPUT1), IC1.12 (INPUT4)
unnamed: ARDUINO.1, BATTERY.1, C1.1, C2.2, D1.A, D2.A, IC1.1 (SEN_A), IC1.8 (GND), IC1.15 (SEN_B), POWER.2
unnamed: D0-7.5, IC1.7 (INPUT2), IC1.10 (INPUT3)
unnamed: D0-7.4, IC1.6 (ENABLE_A), IC1.11 (ENABLE_B)

Board: 2 copper layers, 14 parts (1 on the bottom side), 8 nets, no tracks yet.
