Tiberion/important-documents/Bracket, sensor actuator- Addons/Circuit/Eagle/Battery_Management/BatteryManagement.brd

## EAGLE design Bracket, sensor actuator- Addons/Circuit/Eagle/Battery_Management/BatteryManagement.brd (2014-06-21)

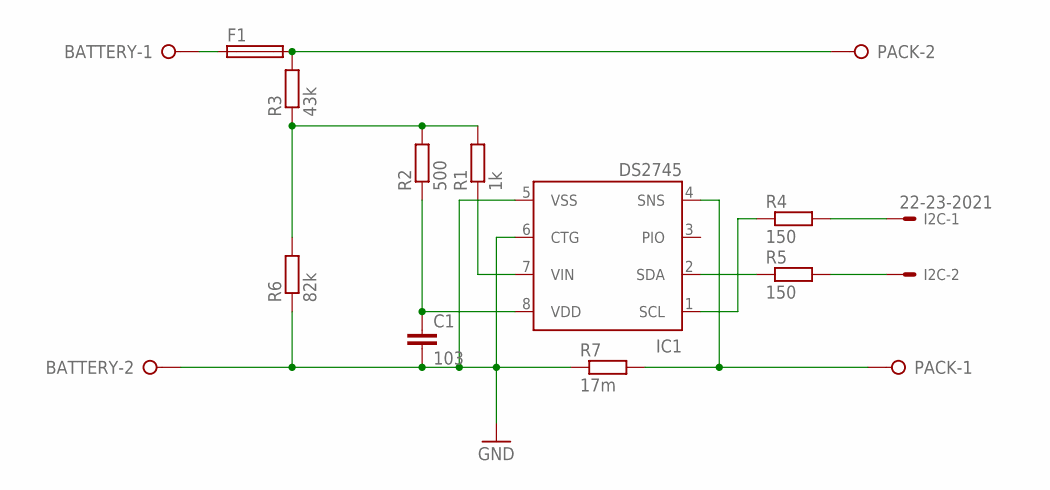
[picture p138: schematic BatteryManagement.sch]

Parts:
BATTERY: W237-02P; W237-132
C1: 103; C050-030X075
F1: SH22,5
I2C: 22-23-2021
IC1: DS2745; UMAX10
PACK: W237-02P; W237-132
R1: 1k; 0207/10
R2: 500; 0207/10
R3: 43k; 0207/10
R4, R5: 150; 0207/10
R6: 82k; 0207/10
R7: 17m; M1206

Connections:
GND: BATTERY.2, C1.2, IC1.5 (VSS), IC1.6 (CTG), R6.1, R7.1
unnamed: I2C.1, R4.2
unnamed: I2C.2, R5.2
unnamed: IC1.1 (SCL), R4.1
unnamed: IC1.2 (SDA), R5.1
unnamed: BATTERY.1, F1.1
unnamed: IC1.7 (VIN), R1.1
unnamed: C1.1, IC1.8 (VDD), R2.1
unnamed: IC1.4 (SNS), PACK.1, R7.2
unnamed: F1.2, PACK.2, R3.2
unnamed: R1.2, R2.2, R3.1, R6.2

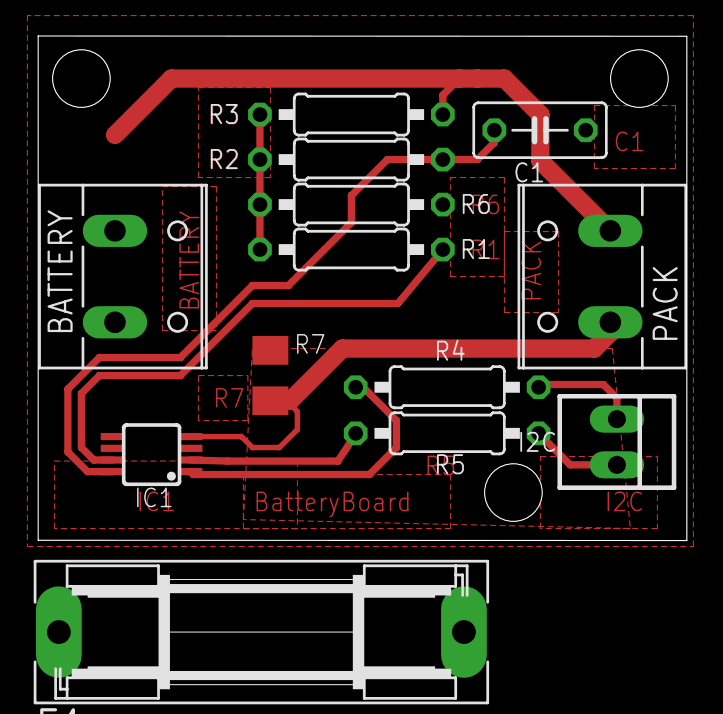
[picture p139: board BatteryManagement.brd from above]

Board: 2 copper layers, 36.0 x 28.0 mm, 13 parts (0 on the bottom side), 11 nets.
