Tiberion/important-documents/Bracket, sensor actuator- Addons/Circuit/Eagle/LEDs/LEDs.brd

## EAGLE design Bracket, sensor actuator- Addons/Circuit/Eagle/LEDs/LEDs.brd (2014-06-21)

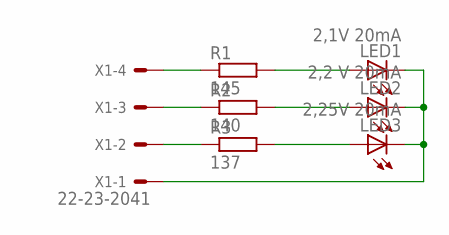
[picture p140: schematic LEDs.sch]

Parts:
LED1: 2,1V 20mA; LED5MM
LED2: 2,2 V 20mA; LED5MM
LED3: 2,25V 20mA; LED5MM
R1: 145; 0207/10
R2: 140; 0207/10
R3: 137; 0207/10
X1: 22-23-2041

Connections:
GND: LED1.K (C), LED2.K (C), LED3.K (C), X1.1
unnamed: R1.1, X1.4
unnamed: R2.1, X1.3
unnamed: R3.1, X1.2
unnamed: LED1.A, R1.2
unnamed: LED2.A, R2.2
unnamed: LED3.A, R3.2

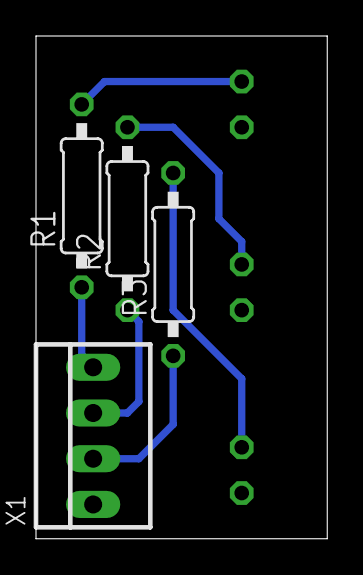
[picture p141: board LEDs.brd from above]

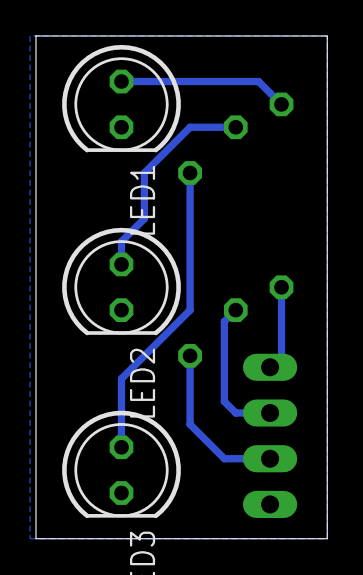
[picture p142: board LEDs.brd from below]

Board: 2 copper layers, 16.2 x 27.9 mm, 7 parts (3 on the bottom side), 7 nets.
