Tiberion/important-documents/(commit log)

2014-05-27 Revert "Delete Projektseminar 2013_03_25 Behlau_Vogel Entwicklung eines eigenen Motor Shields.pdf"
    This reverts commit 9d1a5466d24cf41230e0dc8e41253ae30edb3140.
2014-06-21 upload aller dokumente
    [BatteryManagement.brd, BatteryManagement.sch, BatteryManagement_neu.brd, BatteryManagement_neu.sch, Befestigung.ipt, Galaxy S2.ipt, Grundplatte.ipt, Grundplatte_zerlegt.ipt]
2014-06-21 Umbenennung Strukturierung
    [Light board.brd, Light board.sch, arduino_Uno_Rev3-02-TH.brd, arduino_Uno_Rev3-02-TH.sch, motor steering V1.sch, motor steering V2.brd, motor steering old version.brd, motor steering old version.sch]
